anghernandez/angie-projects/pid-obstacle-avoidance-robot/media/modelo.jpg

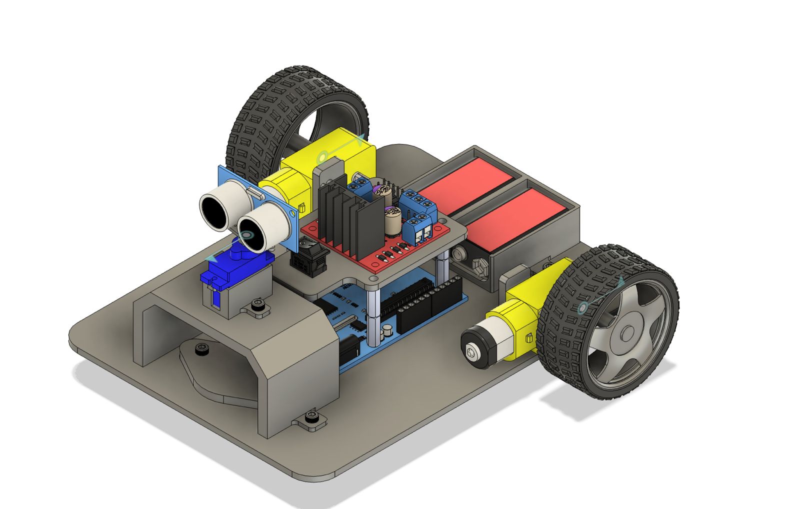
pid-obstacle-avoidance-robot/media/modelo.jpg
