anghernandez/angie-projects/pid-obstacle-avoidance-robot/media/carrito.JPG

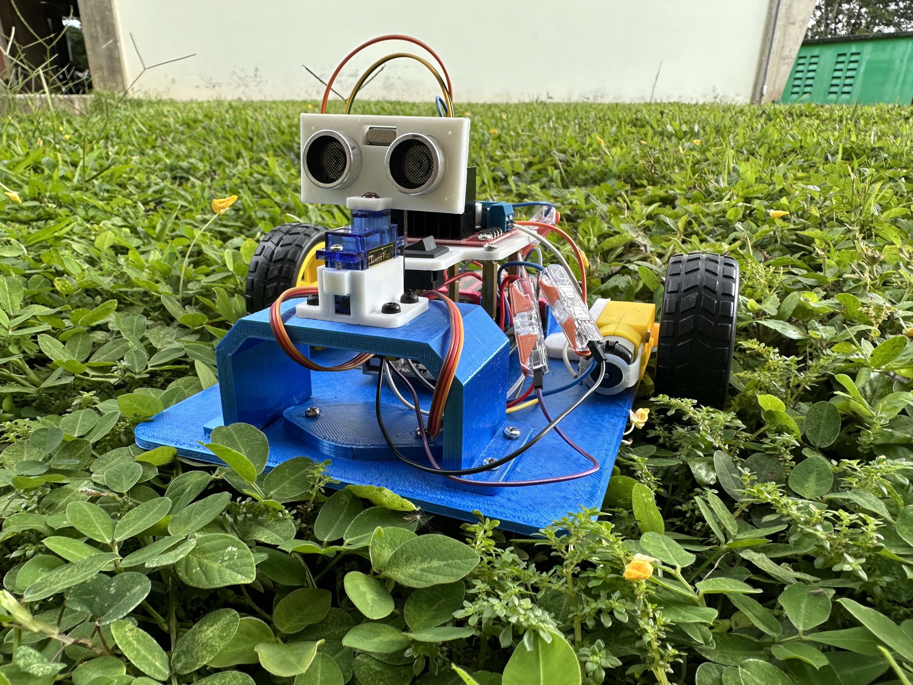
pid-obstacle-avoidance-robot/media/carrito.JPG
