anghernandez/angie-projects/pid-obstacle-avoidance-robot/docs/Proyecto Final.pdf

## Instituto Tecnológico de Costa Rica

## Escuela de Ingeniería Electrónica Laboratorio de Control Automático

# Carrito Evasor de Obstáculos

## Proyecto Fase 2

### Estudiantes:

### Nicole Corrales, Kimberley Morales, Angie Hernández

### Profesor: Pablo César Rodríguez Vargas

### Fecha: 20 de Noviembre 2025

## Contents

1 Introducción | 2
2 Proceso de Construcción | 3
3 Modelo Empírico de la Planta | 3
4 Diseño del Controlador | 6
5 Resultados | 7
6 Análisis de Resultados | 9
7 Conclusiones y Recomendaciones | 9
8 Bibliografía | 10
A Código Fuente | 11
B Planos de Construcción | 22

Abstract

En este proyecto se desarrolla una planta constituida por un carro móvil evasor de obstáculos, cuya dinámica se modela a partir de datos experimentales con el fin de diseñar un controlador adecuado, el sistema emplea un sensor ultrasónico para medir la distancia frente a los obstáculos, dos motores DC controlados mediante un driver L298N, una rueda loca frontal y un módulo Arduino como unidad de procesamiento. A partir del modelo empírico obtenido, se implementa un controlador PID orientado a mejorar la estabilidad y el comportamiento dinámico del vehículo ante variaciones en su entorno.
Los resultados experimentales demuestran que el controlador incrementa la estabilidad del sistema y permite un desplazamiento más preciso y seguro, manteniendo una distancia adecuada frente a obstáculos y mejorando la respuesta general del carro.

Palabras clave: control PID, modelo empírico, carro evasor de obstáculos, control automático, dinámica de sistemas.

## 1 Introducción

El proyecto desarrollado consiste en el diseño, modelado e implementación de un sistema de control aplicado a un carro móvil evasor de obstáculos, la motivación radica en llevar a la práctica los principios teóricos estudiados en el curso de Control Automático, aplicando metodologías reales de modelado, identificación, diseño de controladores y validación experimental. El trabajo permite integrar el análisis matemático con experimentación física, el uso de herramientas como MATLAB y la puesta en marcha de un sistema funcional construido desde cero.
La planta está conformada por un vehículo móvil de dos ruedas motrices y una rueda loca frontal, equipado con un sensor ultrasónico encargado de medir la distancia frontal df ante un obstáculo, el sistema utiliza un Arduino como unidad de procesamiento, un driver L298N para accionar los motores y una señal PWM compartida como variable manipulada. De esta forma, la velocidad lineal del carro depende directamente del valor de la señal de control aplicada, permitiendo influir sobre su capacidad de aproximarse o alejarse de objetos en su trayectoria.
Con base en los datos experimentales obtenidos, se construyó un modelo empírico que describe la relación dinámica entre la señal PWM aplicada a los motores (entrada u) y la distancia frontal medida (salida y = df ). Este modelo permitió diseñar un controlador PID orientado a regular la distancia del vehículo respecto a un obstáculo, manteniéndola en un valor deseado dref. El objetivo de control consiste en garantizar estabilidad, rechazo de perturbaciones y una respuesta suave ante variaciones inesperadas en el entorno. Este documento presenta el desarrollo completo del proyecto, desde la construcción física del prototipo hasta el diseño, simulación e implementación del controlador, mostrando el desempeño obtenido con y sin compensación.

## 2 Proceso de Construcción

El prototipo del carro evasor de obstáculos fue construido mediante un diseño modular fabricado completamente en impresión 3D, cada componente estructural se elaboró como una pieza independiente para facilitar el ensamblaje, mantenimiento y reemplazo, se desarrollaron módulos específicos para la base principal, soporte de baterías, soporte del driver L298N, plataforma frontal, bases de motor y la estructura destinada al sensor ultrasónico y al servomotor.
La locomoción del vehículo se realiza mediante dos motores DC laterales, cada uno fijado a una base impresa que permite una sujeción rígida y estable, en el extremo frontal se incorpora una rueda loca montada dentro de una cavidad diseñada para garantizar un movimiento suave y evitar atascos al cambiar de dirección. La estructura general proporciona rigidez mecánica y distribuye el peso de forma uniforme sobre el chasis. Para la detección de obstáculos se empleó un sensor ultrasónico HC-SR04, montado en la parte frontal sobre una base elevada creada para asegurar que el sensor permanezca perpendicular a los objetos en su trayectoria. El soporte fue fijado mediante tornillería, logrando un alineamiento estable y evitando vibraciones, inicialmente, los motores fueron instalados en posición vertical, pero debido a problemas de fragilidad en la base impresa, se rediseñó la instalación para colocarlos en posición horizontal, mejorando así la resistencia mecánica del conjunto.
El sistema se alimenta mediante dos baterías recargables de 9 V conectadas en serie para incrementar el voltaje disponible, estas alimentan directamente el driver L298N, el cual distribuye energía tanto a los motores como al Arduino. No fue necesario el uso de una protoboard, ya que todas las conexiones funcionales se realizaron a través de los bornes del driver y los pines del microcontrolador, reduciendo el cableado y mejorando la estabilidad eléctrica.
Finalmente, se integró todo el sistema dentro del chasis 3D, asegurando accesibilidad al Arduino y al driver, espacio para las baterías y buena ventilación alrededor de los componentes.

## 3 Modelo Empírico de la Planta

Para obtener un modelo dinámico que describiera el comportamiento del carro móvil frente a variaciones de la señal de control, se realizaron tres experimentos utilizando diferentes niveles de PWM aplicados a los motores: 90, 110 y 130. En cada prueba, el vehículo se desplazó directamente hacia un obstáculo mientras se registraban simultáneamente la señal de entrada u(t) (PWM) y la distancia frontal df (t) medida mediante el sensor ultrasónico HC-SR04. Las señales se adquirieron con un tiempo de muestreo de Ts = 0.05 s.
Previo a cada experimento, se añadió un bloque de muestras en reposo para garantizar un inicio consistente y permitir que el algoritmo de identificación considerara correctamente el instante del escalón. Los datos fueron organizados en objetos iddata de

MATLAB para su posterior procesamiento.

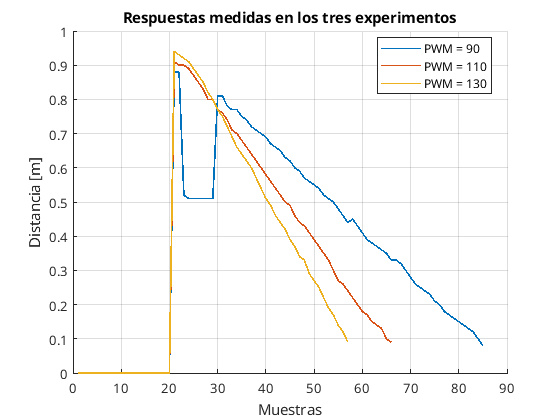
[picture p3: figure]

Figure 1: Respuestas medidas en los tres experimentos realizados con PWM = 90, 110 y 130.

La Fig. 1 muestra las respuestas medidas a los distintos niveles de PWM, se observa que valores mayores de PWM producen un acercamiento más rápido al obstáculo, lo cual confirma la naturaleza monótona del sistema dinámico.
Del conjunto de datos disponible, se seleccionó la medición asociada a PWM = 110 como referencia para la identificación del modelo, por presentar un comportamiento intermedio y menos afectado por saturación o ruido. A partir de estos datos se estimaron distintos modelos mediante el comando tfest, evaluando las siguientes estructuras:
- Modelo de un polo (primer orden)
- Modelo de dos polos
- Modelo de un polo con retardo puro

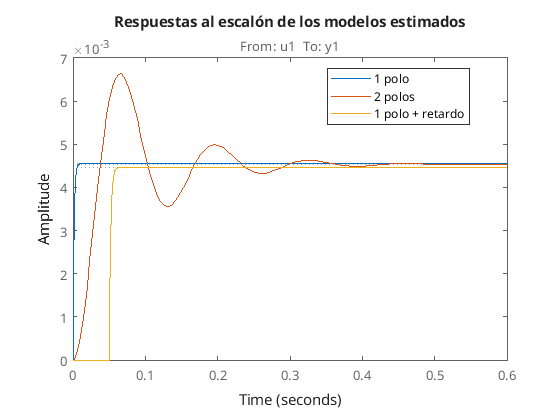
[picture p4: figure]

Figure 2: Comparación de la respuesta al escalón de los modelos estimados.

La Fig. 2 muestra la comparación entre los distintos modelos estimados. El modelo de dos polos presentó el mejor ajuste global, logrando reproducir con mayor fidelidad la curvatura inicial y el comportamiento transitorio observado en los datos experimentales. A diferencia del modelo de un polo, que resulta más simplificado, el modelo de dos polos captura mejor los efectos dinámicos adicionales presentes en la señal real, reduciendo el error entre el modelo y la medición.
El modelo seleccionado corresponde entonces a un sistema de dos polos, cuya estructura general es:
G(s) = | K (s + p1)(s + p2)
,

con los parámetros estimados mediante tfest:

- Ganancia: K ≈ 4.2 × 10⁻³
- Primer polo: p1 ≈ 20.8
- Segundo polo: p2 ≈ 1.64

Este modelo describe de mejor manera la dinámica del sistema, especialmente en el régimen transitorio, y constituye la base utilizada para el diseño del controlador PID implementado.
Finalmente, la respuesta al escalón en lazo cerrado con el controlador PID diseñado (ver Sección correspondiente) se muestra en la Fig. 3, la cual evidencia que el modelo identificado permite obtener una compensación estable y con buen desempeño dinámico.

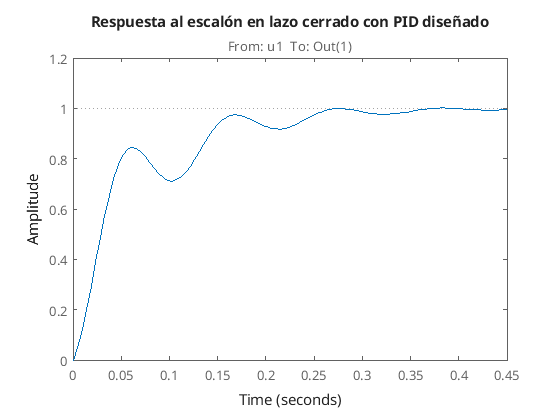
[picture p5: figure]

Figure 3: Respuesta al escalón en lazo cerrado utilizando el PID diseñado.

## 4 Diseño del Controlador

El diseño del controlador se realizó utilizando el modelo empírico identificado previamente para la planta, a partir de los datos experimentales, el sistema se aproximó mediante un modelo discreto de dos polos con tiempo de muestreo Ts = 0.05 s, el cual fue empleado dentro de MATLAB para el diseño y ajuste de un controlador PID orientado a regular la distancia frontal df a un valor de referencia dref.
El objetivo principal del controlador era reducir el error en estado estacionario y mejorar la estabilidad del acercamiento al obstáculo, evitando oscilaciones o convergencias bruscas. Para ello, se utilizó la herramienta pidtune de MATLAB, tomando como punto de partida el modelo discreto obtenido mediante tfest, con este procedimiento se generaron parámetros iniciales del PID, que posteriormente fueron ajustados manualmente para obtener una respuesta más suave y con menor tiempo de establecimiento. Dado que la implementación final debía ejecutarse en un microcontrolador Arduino, se adoptó una formulación de PID incremental, la cual es numéricamente robusta, reduce problemas de saturación integral y es menos sensible al ruido de medición. El controlador incremental se expresa como:

u(k) = u(k − 1) + A e(k) + B e(k − 1) + C e(k − 2),

donde e(k) = dref − df (k) es el error en el instante k, y los coeficientes incrementales se relacionan con los parámetros clásicos del PID mediante discretización.

Los valores finales utilizados en la implementación fueron:

Ainc = 66.805, | Binc = −13.432, | Cinc = 4.705.

Estos coeficientes provienen de escalar los valores obtenidos por MATLAB (222.6841, −44.7737, 15.6834) mediante un factor de 0.3, lo cual permitió adecuar las magnitudes de control a la dinámica real del carro y evitar saturación del actuador (PWM).

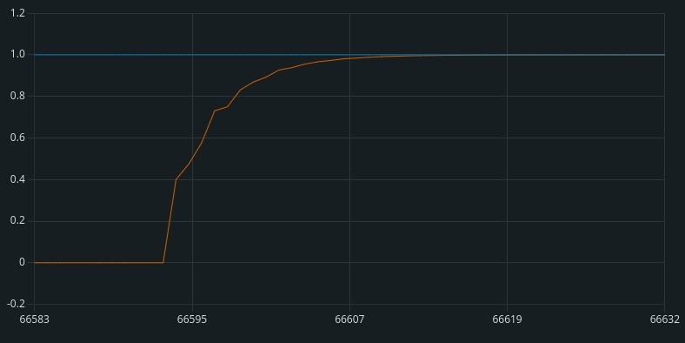
[picture p6: figure]

Figure 4: Respuesta al escalón obtenida en la simulación del PID implementado en Arduino.

La Fig. 4 muestra que el sistema converge suavemente hacia la referencia, sin sobrepaso significativo y con comportamiento estable, validando así el diseño del controlador.

## 5 Resultados

En esta sección se presentan los comportamientos experimentales del sistema sin control y con el controlador PID implementado, con el fin de comparar el desempeño dinámico en ambos casos.

### 5.1 Sistema sin compensación

Las pruebas sin controlador muestran que el vehículo no es capaz de mantener una distancia estable respecto al obstáculo. Al aplicar un PWM fijo, la distancia frontal disminuye de manera casi lineal, evidenciando que el sistema carece de mecanismos de regulación. Las respuestas de distancia para distintos niveles de PWM se muestran en la Fig. 5.

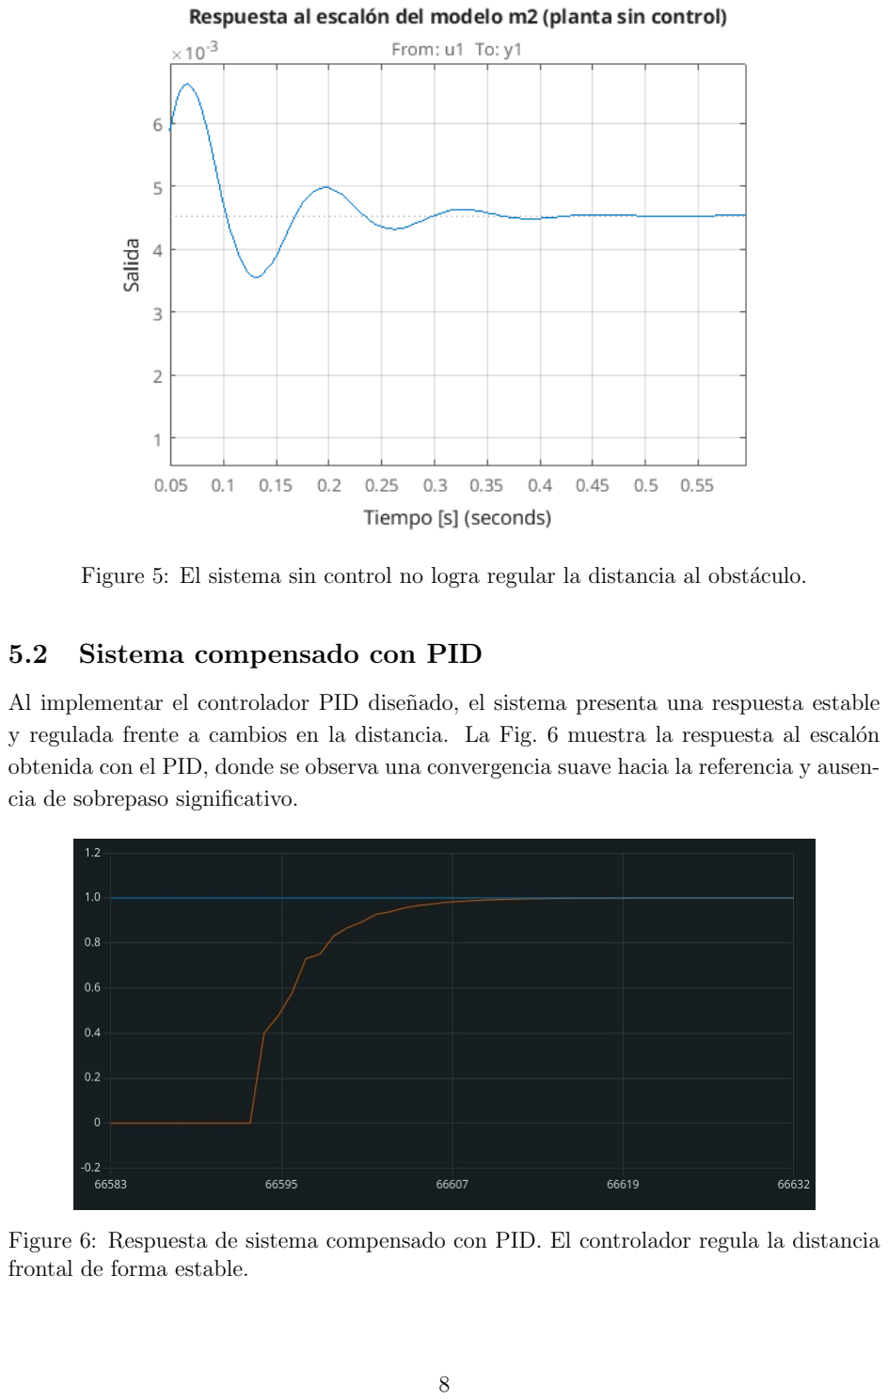
[picture p7: page 9]

Figure 5: El sistema sin control no logra regular la distancia al obstáculo.

### 5.2 Sistema compensado con PID

Al implementar el controlador PID diseñado, el sistema presenta una respuesta estable y regulada frente a cambios en la distancia. La Fig. 6 muestra la respuesta al escalón obtenida con el PID, donde se observa una convergencia suave hacia la referencia y ausencia de sobrepaso significativo.

Figure 6: Respuesta de sistema compensado con PID. El controlador regula la distancia frontal de forma estable.

## 6 Análisis de Resultados

Los resultados obtenidos evidencian que el controlador PID diseñado cumple de manera efectiva con los objetivos de regulación planteados para el sistema, en las pruebas sin control, el carro se aproxima al obstáculo de forma no regulada, mostrando un comportamiento dominado únicamente por la velocidad de los motores y sin capacidad de mantener una distancia estable. Este comportamiento confirma que la planta, por sí sola, no posee mecanismos de estabilización ni rechazo de perturbaciones.
Una vez implementado el controlador PID, la dinámica del sistema cambia de forma significativa, la respuesta al escalón en lazo cerrado muestra una convergencia suave hacia la referencia, sin sobrepasos relevantes y con un error en estado estacionario prácticamente nulo. El controlador compensa adecuadamente las variaciones en la distancia detectada, ajustando la señal PWM para mantener el valor deseado incluso ante perturbaciones. La comparación entre ambos escenarios demuestra que el PID logra transformar un sistema inherentemente no regulado en uno estable y capaz de mantener un comportamiento controlado. La dinámica obtenida en lazo cerrado es consistente con el modelo identificado, validando tanto el proceso de identificación como la metodología de diseño del controlador. Además, los resultados experimentales concuerdan con las simulaciones realizadas, lo cual confirma que los parámetros ajustados del PID son adecuados para la planta real.
En conjunto, los resultados permiten concluir que el control aplicado es preciso, robusto y cumple los objetivos propuestos en términos de regulación, estabilidad y rechazo de perturbaciones, garantizando un comportamiento seguro del carro durante el movimiento.

## 7 Conclusiones y Recomendaciones

### 7.1 Conclusiones

El proyecto cumplió de manera satisfactoria con los objetivos planteados, el modelo empírico obtenido fue adecuado para representar la dinámica principal del sistema y permitió diseñar un controlador PID funcional. Con el control implementado, el carro fue capaz de reaccionar correctamente ante un obstáculo y ajustar su distancia de manera rápida y estable, demostrando la efectividad del enfoque aplicado.
El trabajo permitió comprender de manera práctica el proceso completo de diseño de un sistema de control: desde la obtención de datos y modelado de la planta, hasta la implementación del PID en hardware real. Durante el desarrollo se identificó inicialmente una incompatibilidad entre el modelo empírico y el controlador diseñado, lo que llevó a un proceso de ajuste y validación que fortaleció la comprensión del comportamiento real de la planta y de los parámetros del PID.
El proyecto también permitió observar limitaciones prácticas del sistema, como la diferencia de respuesta entre los motores, que ocasionaba desviaciones laterales, este comportamiento mostró que, aunque el controlador regulaba la distancia frontal, el desempeño en trayectoria dependía de factores mecánicos adicionales no incluidos en el modelo.
En conjunto, el sistema logró un control estable, preciso y funcional, cumpliendo con los objetivos académicos y prácticos establecidos.

### 7.2 Recomendaciones

Para trabajos futuros, se recomienda explorar controladores más avanzados que permitan no solo regular la distancia frontal, sino también mejorar el seguimiento de trayectoria y compensar diferencias entre motores, entre las posibles mejoras se destacan:

- implementar controladores independientes por rueda, integrando control diferencial;
- añadir filtrado a la señal del sensor ultrasónico para reducir ruido y mejorar la

medición;

- incorporar sensores adicionales como encoders o unidades inerciales (IMU);
- utilizar motores con mayor precisión o realimentación interna;
- extender el control para permitir giros, evasión lateral y navegación autónoma.

Además, se sugiere continuar refinando el proceso de identificación de la planta, considerando modelos más completos o técnicas avanzadas de identificación no lineal.

## 8 Bibliografía

[1] C. Rincón, J. Martínez, y A. Rodríguez, “Diseño sistema PID para el control de distancia de un vehículo seguidor de objetos,” 19th LACCEI Multi-Conference, Buenos Aires, Argentina, 2021. :contentReference[oaicite:0]index=0
[2] J. I. Collazo, E. Gorrostieta, J. Pedraza, U. Villaseñor, R. Romero, y
M. González, “Modelación de un robot móvil de dos ruedas con tracción diferencial,” 8º Congreso Nacional de Mecatrónica, Veracruz, México, 2009. :contentRefer-

ence[oaicite:1]index=1

[3] ElecFreaks, “HC-SR04 Ultrasonic Sensor Datasheet,” 2013. [En línea]. Disponible en: https://cdn.sparkfun.com/datasheets/Sensors/Proximity/HCSR04.pdf
[4] STMicroelectronics, “L298N Dual H-Bridge Motor Driver Datasheet,” 2010. [En línea]. Disponible en: https://www.st.com/resource/en/datasheet/l298.pdf
[5] Arduino Documentation, “PWM — Pulse Width Modulation,” 2024. [En línea]. Disponible en: https://docs.arduino.cc/learn/microcontrollers/

analog-output (https://docs.arduino.cc/learn/microcontrollers/analog-output)

[6] MathWorks, “System Identification Toolbox Documentation,” 2024. [En línea]. Disponible en: https://www.mathworks.com/help/ident
[7] MathWorks, “PID Tuning and Control Design,” 2024. [En línea]. Disponible en: https://www.mathworks.com/help/control/ref/pidtuner-app.html
[8] K. Ogata, Ingeniería de Control Moderna, 5ta ed., Pearson, 2010.

## A Código Fuente

Listing 1: Control PID para la planta

1
2 | # include < NewPing .h >
3 | # include < Servo .h >

4
5 Servo servoSensor ;

6
7 | # define TRIG_PIN A3
8 | # define ECHO_PIN A2
9 | # define MAX_DISTANCE 200
10 | NewPing sonar ( TRIG_PIN , ECHO_PIN , MAX_DISTANCE ) ;

11
12 | const int ENA = 5;
13 | const int IN1 = 10;
14 | const int IN2 = 8;
15 | const int ENB = 6;
16 | const int IN3 = 11;
17 | const int IN4 = 7;

18
19 | const double Ts = 0.05;
20 | unsigned long t0 ;

21
22 double ref = 0.30;

23
24 | const double Ainc = 0.25 * 222.6841;
25 | const double Binc = 0.25 * -44.7737;
26 | const double Cinc = 0.25 * 15.6834;

27
28 | double ek | = 0.0;
29 | double ekm1 = 0.0;
30 | double ekm2 = 0.0;
31 | double uk | = 0.0;
32 | double ukm1 = 0.0;

33
34 | double d_ema = 0.0;
35 | const double EMA_ALPHA = 0.2;

36
37 const double CTRL_GAIN = 13.0;

38 | const int | PWM_MAX | = 220;
39 | const int | PWM_MIN | = 70;

40
41 const double REF_BAND = 0.02;

42
43 const double D_EMERGENCY = 0.15;

44
45 bool INVERT_DIR = true ;

46
47 | const int OFFSET_RIGHT_FWD = 21;
48 | const int OFFSET_RIGHT_REV = 20;

49
50 | const int SERVO_CENTER = 90;
51 | const int SERVO_LEFT1 | = 120;
52 | const int SERVO_LEFT2 | = 140;
53 | const int SERVO_RIGHT1 = 60;
54 | const int SERVO_RIGHT2 = 40;

55
56 | const int TURN_PWM | = 130;
57 | const int TURN_STEPS | = 12;

58
59 | enum Mode { MODE_FOLLOW , MODE_AVOID_TURN };
60 | Mode mode = MODE_FOLLOW ;
61 | int | turnDir | = 0;
62 | int | turnSteps = 0;

63
64 | static inline float median3 ( float a , float b , float c ) {
65 | if ( a > b ) { float t = a ; a = b ; b = t ; }
66 | if ( b > c ) { float t = b ; b = c ; c = t ; }
67 | if ( a > b ) { float t = a ; a = b ; b = t ; }
68 | return b ;
69 | }

70
71 | double readDistanceM () {
72 | unsigned int c1 = sonar . ping_cm () ; if (! c1 ) c1 = MAX_DISTANCE ;
73 | unsigned int c2 = sonar . ping_cm () ; if (! c2 ) c2 = MAX_DISTANCE ;
74 | unsigned int c3 = sonar . ping_cm () ; if (! c3 ) c3 = MAX_DISTANCE ;
75 | float cm = median3 ( c1 , c2 , c3 ) ;
76 | return cm / 100.0;
77 | }

78
79 | double meanDistanceAtAngle (int angleDeg , int nSamples = 3) {
80 | servoSensor . write ( angleDeg ) ;
81 | delay (150) ;
82 | double sum = 0.0;
83 | for ( int i = 0; i < nSamples ; i ++) {
84 | double d = readDistanceM () ;
85 | if ( d > 2.0) d = 2.0;
86 | sum += d ;
87 | delay (40) ;
88 | }

89 | return sum / ( double ) nSamples ;
90 | }

91
92 | double scanSideMean (int side ) {
93 | double m1 , m2 ;
94 | if ( side < 0) {
95 | m1 = meanDistanceAtAngle ( SERVO_LEFT1 ) ;
96 | m2 = meanDistanceAtAngle ( SERVO_LEFT2 ) ;
97 | } else {
98 | m1 = meanDistanceAtAngle ( SERVO_RIGHT1 ) ;
99 | m2 = meanDistanceAtAngle ( SERVO_RIGHT2 ) ;
100 | }
101 | return 0.5 * ( m1 + m2 ) ;
102 | }

103
104 | void driveSignedPWM (int uSigned ) {
105 | int s = ( uSigned >= 0) ? +1 : -1;
106 | if ( INVERT_DIR ) s = -s ;

107
108 | int base = abs ( uSigned ) ;
109 | if ( base > PWM_MAX ) base = PWM_MAX ;

110
111 | int valLeft | = base ;
112 | int valRight = base ;

113
114 | if ( s > 0) {
115 | valRight -= OFFSET_RIGHT_FWD ;
116 | if ( valRight < 0) valRight = 0;
117 | } else {
118 | valRight -= OFFSET_RIGHT_REV ;
119 | if ( valRight < 0) valRight = 0;
120 | }

121
122 | digitalWrite ( IN1 , ( s > 0) ? HIGH : LOW ) ;
123 | digitalWrite ( IN2 , ( s > 0) ? LOW | : HIGH ) ;
124 | digitalWrite ( IN3 , ( s > 0) ? HIGH : LOW ) ;
125 | digitalWrite ( IN4 , ( s > 0) ? LOW | : HIGH ) ;

126
127 | analogWrite ( ENA , valLeft ) ;
128 | analogWrite ( ENB , valRight ) ;
129 | }

130
131 | void driveTurnInPlace (int dir , int pwm ) {
132 | if ( pwm > PWM_MAX ) pwm = PWM_MAX ;
133 | if ( pwm < PWM_MIN ) pwm = PWM_MIN ;

134
135 | if ( dir > 0) {
136 | digitalWrite ( IN1 , HIGH ) ; digitalWrite ( IN2 , LOW ) ;
137 | digitalWrite ( IN3 , LOW ) ; | digitalWrite ( IN4 , HIGH ) ;
138 | } else {
139 | digitalWrite ( IN1 , LOW ) ; | digitalWrite ( IN2 , HIGH ) ;

140 | digitalWrite ( IN3 , HIGH ) ; digitalWrite ( IN4 , LOW ) ;
141 | }

142
143 | analogWrite ( ENA , pwm ) ;
144 | analogWrite ( ENB , pwm ) ;
145 | }

146
147 | void resetPID () {
148 | uk | = 0.0;
149 | ukm1 = 0.0;
150 | ekm1 = 0.0;
151 | ekm2 = 0.0;
152 | }

153
154 | void startAvoidance () {
155 | driveSignedPWM (0) ;
156 | resetPID () ;

157
158 | double dLeftMean | = scanSideMean ( -1) ;
159 | double dRightMean = scanSideMean (+1) ;

160
161 | servoSensor . write ( SERVO_CENTER ) ;
162 | delay (150) ;

163
164 | if ( dLeftMean > dRightMean ) turnDir = -1;
165 | else | turnDir = +1;

166
167 | turnSteps = TURN_STEPS ;
168 | mode = MODE_AVOID_TURN ;

169
170 | t0 = millis () ;
171 | }

172
173 | void setup () {
174 | Serial . begin (115200) ;

175
176 | servoSensor . attach (9) ;
177 | servoSensor . write ( SERVO_CENTER ) ;
178 | delay (200) ;

179
180 | pinMode ( ENA , OUTPUT ) ; pinMode ( ENB , OUTPUT ) ;
181 | pinMode ( IN1 , OUTPUT ) ; pinMode ( IN2 , OUTPUT ) ;
182 | pinMode ( IN3 , OUTPUT ) ; pinMode ( IN4 , OUTPUT ) ;

183
184 | digitalWrite ( IN1 , LOW ) ; | digitalWrite ( IN2 , LOW ) ;
185 | digitalWrite ( IN3 , LOW ) ; | digitalWrite ( IN4 , LOW ) ;

186
187 | d_ema = readDistanceM () ;
188 | t0 = millis () ;
189 | }

190

191 | void loop () {
192 | if ( millis () - t0 < ( unsigned long ) ( Ts * 1000.0) ) return ;
193 | t0 += ( unsigned long ) ( Ts * 1000.0) ;

194
195 | double dist = readDistanceM () ;
196 | if ( dist > 2.0) dist = 2.0;

197
198 d_ema = (1.0 - EMA_ALPHA ) * d_ema + EMA_ALPHA * dist ;

199
200 | if ( mode == MODE_FOLLOW ) {
201 | ek = ref - d_ema ;

202
203 | if ( d_ema < D_EMERGENCY ) {
204 | startAvoidance () ;
205 | Serial . print ( ref , 3) ;
206 | Serial . print (" ") ;
207 | Serial . println ( d_ema , 3) ;
208 | return ;
209 | }

210
211 | if ( fabs ( ek ) <= REF_BAND ) {
212 | startAvoidance () ;
213 | Serial . print ( ref , 3) ;
214 | Serial . print (" ") ;
215 | Serial . println ( d_ema , 3) ;
216 | return ;
217 | }

218
219 | uk = ukm1 + Ainc * ek + Binc * ekm1 + Cinc * ekm2 ;

220
221 | if ( uk > | 10.0) uk = | 10.0;
222 | if ( uk < -10.0) uk = -10.0;

223
224 | double uAbs = fabs ( uk ) * CTRL_GAIN ;
225 | int pwm = ( int ) uAbs ;
226 | if ( pwm > PWM_MAX ) pwm = PWM_MAX ;
227 | if ( pwm < PWM_MIN ) pwm = PWM_MIN ;

228
229 | int sign = ( uk >= 0.0) ? +1 : -1;
230 | int uSigned = sign * pwm ;

231
232 | driveSignedPWM ( uSigned ) ;

233
234 | ekm2 = ekm1 ;
235 | ekm1 = ek ;
236 | ukm1 = uk ;

237
238 | Serial . print ( ref , 3) ;
239 | Serial . print (" ") ;
240 | Serial . println ( d_ema , 3) ;
241 | }

242 | else if ( mode == MODE_AVOID_TURN ) {
243 | if ( turnSteps > 0) {
244 | driveTurnInPlace ( turnDir , TURN_PWM ) ;
245 | turnSteps - -;
246 | } else {
247 | driveSignedPWM (0) ;
248 | resetPID () ;
249 | mode = MODE_FOLLOW ;
250 | servoSensor . write ( SERVO_CENTER ) ;
251 | delay (100) ;
252 | }

253
254 | Serial . print ( ref , 3) ;
255 | Serial . print (" ") ;
256 | Serial . println ( d_ema , 3) ;
257 | }
258 | }

Listing 2: Control en modo evasor de obstáculos mediante PID incremental

1 | # include < NewPing .h >
2 | # include < Servo .h >

3
4 | // ----------------------------
5 | // C o n f i g u r a c i n de hardware
6 | // ----------------------------
7 | Servo servoSensor ;

8
9 | # define TRIG_PIN | A3
10 | # define ECHO_PIN | A2
11 | # define MAX_DISTANCE 200

12
13 NewPing sonar ( TRIG_PIN , ECHO_PIN , MAX_DISTANCE ) ;

14
15 | const int ENA = 5;
16 | const int IN1 = 10;
17 | const int IN2 = 8;
18 | const int ENB = 6;
19 | const int IN3 = 11;
20 | const int IN4 = 7;

21
22 | // ----------------------------
23 | // P a r m e t r o s de control
24 | // ----------------------------
25 | const double Ts = 0.05; | // P e r o d o de muestreo [s]
26 | unsigned long t0 ;

27
28 | double ref = 0.30; | // Referencia de distancia [m]

29
30 | // Coeficientes PID incremental ( discretizado )
31 | const double Ainc = 0.25 * 222.6841;

32 | const double Binc = 0.25 * -44.7737;
33 | const double Cinc = 0.25 * 15.6834;

34
35 | double ek | = 0.0;
36 | double ekm1 = 0.0;
37 | double ekm2 = 0.0;
38 | double uk | = 0.0;
39 | double ukm1 = 0.0;

40
41 | // Filtro EMA para la m e d i c i n de distancia
42 | double d_ema = 0.0;
43 | const double EMA_ALPHA = 0.2;

44
45 | // Ganancias y l m i t e s del actuador
46 | const double CTRL_GAIN = 13.0;
47 | const int | PWM_MAX | = 220;
48 | const int | PWM_MIN | = 70;

49
50 | // Banda muerta alrededor de la referencia
51 | const double REF_BAND = 0.02;

52
53 | // Distancia de emergencia para e v a s i n
54 | const double D_EMERGENCY = 0.15;

55
56 | // Ajustes direccionales
57 | bool INVERT_DIR = true ;

58
59 | const int OFFSET_RIGHT_FWD = 21;
60 | const int OFFSET_RIGHT_REV = 20;

61
62 | // | ngulos | del servo
63 | const int SERVO_CENTER = 90;
64 | const int SERVO_LEFT1 | = 120;
65 | const int SERVO_LEFT2 | = 140;
66 | const int SERVO_RIGHT1 = 60;
67 | const int SERVO_RIGHT2 = 40;

68
69 | // P a r m e t r o s de giro evasivo
70 | const int TURN_PWM | = 130;
71 | const int TURN_STEPS = 12;

72
73 | // ----------------------------
74 | // Modos de o p e r a c i n
75 | // ----------------------------
76 | enum Mode { MODE_FOLLOW , MODE_AVOID_TURN };
77 | Mode mode = MODE_FOLLOW ;

78
79 | int turnDir | = 0;
80 | int turnSteps = 0;

81
82 // ----------------------------

83 | // Utilitarios
84 | // ----------------------------
85 | static inline float median3 ( float a , float b , float c ) {
86 | if ( a > b ) { float t = a ; a = b ; b = t ; }
87 | if ( b > c ) { float t = b ; b = c ; c = t ; }
88 | if ( a > b ) { float t = a ; a = b ; b = t ; }
89 | return b ;
90 | }

91
92 | double readDistanceM () {
93 | unsigned int c1 = sonar . ping_cm () ; if (! c1 ) c1 = MAX_DISTANCE ;
94 | unsigned int c2 = sonar . ping_cm () ; if (! c2 ) c2 = MAX_DISTANCE ;
95 | unsigned int c3 = sonar . ping_cm () ; if (! c3 ) c3 = MAX_DISTANCE ;

96
97 | float cm = median3 ( c1 , c2 , c3 ) ;
98 | return cm / 100.0; | // Pasar a metros
99 | }

100
101 | double meanDistanceAtAngle (int angleDeg , int nSamples = 3) {
102 | servoSensor . write ( angleDeg ) ;
103 | delay (150) ;

104
105 | double sum = 0.0;
106 | for ( int i = 0; i < nSamples ; i ++) {
107 | double d = readDistanceM () ;
108 | if ( d > 2.0) d = 2.0; | // Limitar a 2 m
109 | sum += d ;
110 | delay (40) ;
111 | }
112 | return sum / ( double ) nSamples ;
113 | }

114
115 | double scanSideMean (int side ) {
116 | double m1 , m2 ;
117 | if ( side < 0) {
118 | m1 = meanDistanceAtAngle ( SERVO_LEFT1 ) ;
119 | m2 = meanDistanceAtAngle ( SERVO_LEFT2 ) ;
120 | } else {
121 | m1 = meanDistanceAtAngle ( SERVO_RIGHT1 ) ;
122 | m2 = meanDistanceAtAngle ( SERVO_RIGHT2 ) ;
123 | }
124 | return 0.5 * ( m1 + m2 ) ;
125 | }

126
127 | // ----------------------------
128 | // A c t u a c i n sobre motores
129 | // ----------------------------
130 | void driveSignedPWM (int uSigned ) {
131 | int s = ( uSigned >= 0) ? +1 : -1;
132 | if ( INVERT_DIR ) s = -s ;

133

134 | int base = abs ( uSigned ) ;
135 | if ( base > PWM_MAX ) base = PWM_MAX ;

136
137 | int valLeft | = base ;
138 | int valRight = base ;

139
140 | if ( s > 0) {
141 | valRight -= OFFSET_RIGHT_FWD ;
142 | if ( valRight < 0) valRight = 0;
143 | } else {
144 | valRight -= OFFSET_RIGHT_REV ;
145 | if ( valRight < 0) valRight = 0;
146 | }

147
148 | digitalWrite ( IN1 , ( s > 0) ? HIGH : LOW ) ;
149 | digitalWrite ( IN2 , ( s > 0) ? LOW | : HIGH ) ;
150 | digitalWrite ( IN3 , ( s > 0) ? HIGH : LOW ) ;
151 | digitalWrite ( IN4 , ( s > 0) ? LOW | : HIGH ) ;

152
153 | analogWrite ( ENA , valLeft ) ;
154 | analogWrite ( ENB , valRight ) ;
155 | }

156
157 | void driveTurnInPlace (int dir , int pwm ) {
158 | if ( pwm > PWM_MAX ) pwm = PWM_MAX ;
159 | if ( pwm < PWM_MIN ) pwm = PWM_MIN ;

160
161 | if ( dir > 0) {
162 | digitalWrite ( IN1 , HIGH ) ; digitalWrite ( IN2 , LOW ) ;
163 | digitalWrite ( IN3 , LOW ) ; | digitalWrite ( IN4 , HIGH ) ;
164 | } else {
165 | digitalWrite ( IN1 , LOW ) ; | digitalWrite ( IN2 , HIGH ) ;
166 | digitalWrite ( IN3 , HIGH ) ; digitalWrite ( IN4 , LOW ) ;
167 | }

168
169 | analogWrite ( ENA , pwm ) ;
170 | analogWrite ( ENB , pwm ) ;
171 | }

172
173 | // ----------------------------
174 | // G e s t i n del PID
175 | // ----------------------------
176 | void resetPID () {
177 | uk | = 0.0;
178 | ukm1 = 0.0;
179 | ekm1 = 0.0;
180 | ekm2 = 0.0;
181 | }

182
183 | // ----------------------------
184 | // L g i c a de e v a s i n

185 | // ----------------------------
186 | void startAvoidance () {
187 | driveSignedPWM (0) ;
188 | resetPID () ;

189
190 | double dLeftMean | = scanSideMean ( -1) ;
191 | double dRightMean = scanSideMean (+1) ;

192
193 | servoSensor . write ( SERVO_CENTER ) ;
194 | delay (150) ;

195
196 | if ( dLeftMean > dRightMean ) turnDir = -1;
197 | else | turnDir = +1;

198
199 | turnSteps = TURN_STEPS ;
200 | mode | = MODE_AVOID_TURN ;

201
202 | t0 = millis () ;
203 | }

204
205 | // ----------------------------
206 | // Setup y bucle principal
207 | // ----------------------------
208 | void setup () {
209 | Serial . begin (115200) ;

210
211 | servoSensor . attach (9) ;
212 | servoSensor . write ( SERVO_CENTER ) ;
213 | delay (200) ;

214
215 | pinMode ( ENA , OUTPUT ) ; pinMode ( ENB , OUTPUT ) ;
216 | pinMode ( IN1 , OUTPUT ) ; pinMode ( IN2 , OUTPUT ) ;
217 | pinMode ( IN3 , OUTPUT ) ; pinMode ( IN4 , OUTPUT ) ;

218
219 | digitalWrite ( IN1 , LOW ) ; | digitalWrite ( IN2 , LOW ) ;
220 | digitalWrite ( IN3 , LOW ) ; | digitalWrite ( IN4 , LOW ) ;

221
222 | d_ema = readDistanceM () ;
223 | t0 | = millis () ;
224 | }

225
226 | void loop () {
227 | if ( millis () - t0 < ( unsigned long ) ( Ts * 1000.0) ) return ;
228 | t0 += ( unsigned long ) ( Ts * 1000.0) ;

229
230 | double dist = readDistanceM () ;
231 | if ( dist > 2.0) dist = 2.0;

232
233 | // Filtro EMA
234 | d_ema = (1.0 - EMA_ALPHA ) * d_ema + EMA_ALPHA * dist ;

235

236 | if ( mode == MODE_FOLLOW ) {
237 | ek = ref - d_ema ;

238
239 | // Condiciones para iniciar e v a s i n
240 | if ( d_ema < D_EMERGENCY ) {
241 | startAvoidance () ;
242 | Serial . print ( ref , 3) ;
243 | Serial . print (" ") ;
244 | Serial . println ( d_ema , 3) ;
245 | return ;
246 | }

247
248 | if ( fabs ( ek ) <= REF_BAND ) {
249 | startAvoidance () ;
250 | Serial . print ( ref , 3) ;
251 | Serial . print (" ") ;
252 | Serial . println ( d_ema , 3) ;
253 | return ;
254 | }

255
256 | // PID incremental
257 | uk = ukm1 + Ainc * ek + Binc * ekm1 + Cinc * ekm2 ;

258
259 | if ( uk > | 10.0) uk = | 10.0;
260 | if ( uk < -10.0) uk = -10.0;

261
262 | double uAbs = fabs ( uk ) * CTRL_GAIN ;
263 | int pwm = ( int ) uAbs ;
264 | if ( pwm > PWM_MAX ) pwm = PWM_MAX ;
265 | if ( pwm < PWM_MIN ) pwm = PWM_MIN ;

266
267 | int sign | = ( uk >= 0.0) ? +1 : -1;
268 | int uSigned = sign * pwm ;

269
270 | driveSignedPWM ( uSigned ) ;

271
272 | ekm2 = ekm1 ;
273 | ekm1 = ek ;
274 | ukm1 = uk ;

275
276 | Serial . print ( ref , 3) ;
277 | Serial . print (" ") ;
278 | Serial . println ( d_ema , 3) ;
279 | }
280 | else if ( mode == MODE_AVOID_TURN ) {
281 | if ( turnSteps > 0) {
282 | driveTurnInPlace ( turnDir , TURN_PWM ) ;
283 | turnSteps - -;
284 | } else {
285 | driveSignedPWM (0) ;
286 | resetPID () ;

287 | mode = MODE_FOLLOW ;
288 | servoSensor . write ( SERVO_CENTER ) ;
289 | delay (100) ;
290 | }

291
292 | Serial . print ( ref , 3) ;
293 | Serial . print (" ") ;
294 | Serial . println ( d_ema , 3) ;
295 | }
296 | }

## B Planos de Construcción

A continuación se presentan los planos de fabricación utilizados para la construcción del prototipo del carro evasor de obstáculos, cada plano fue modelado en CAD e impreso en 3D para conformar la estructura completa del robot.

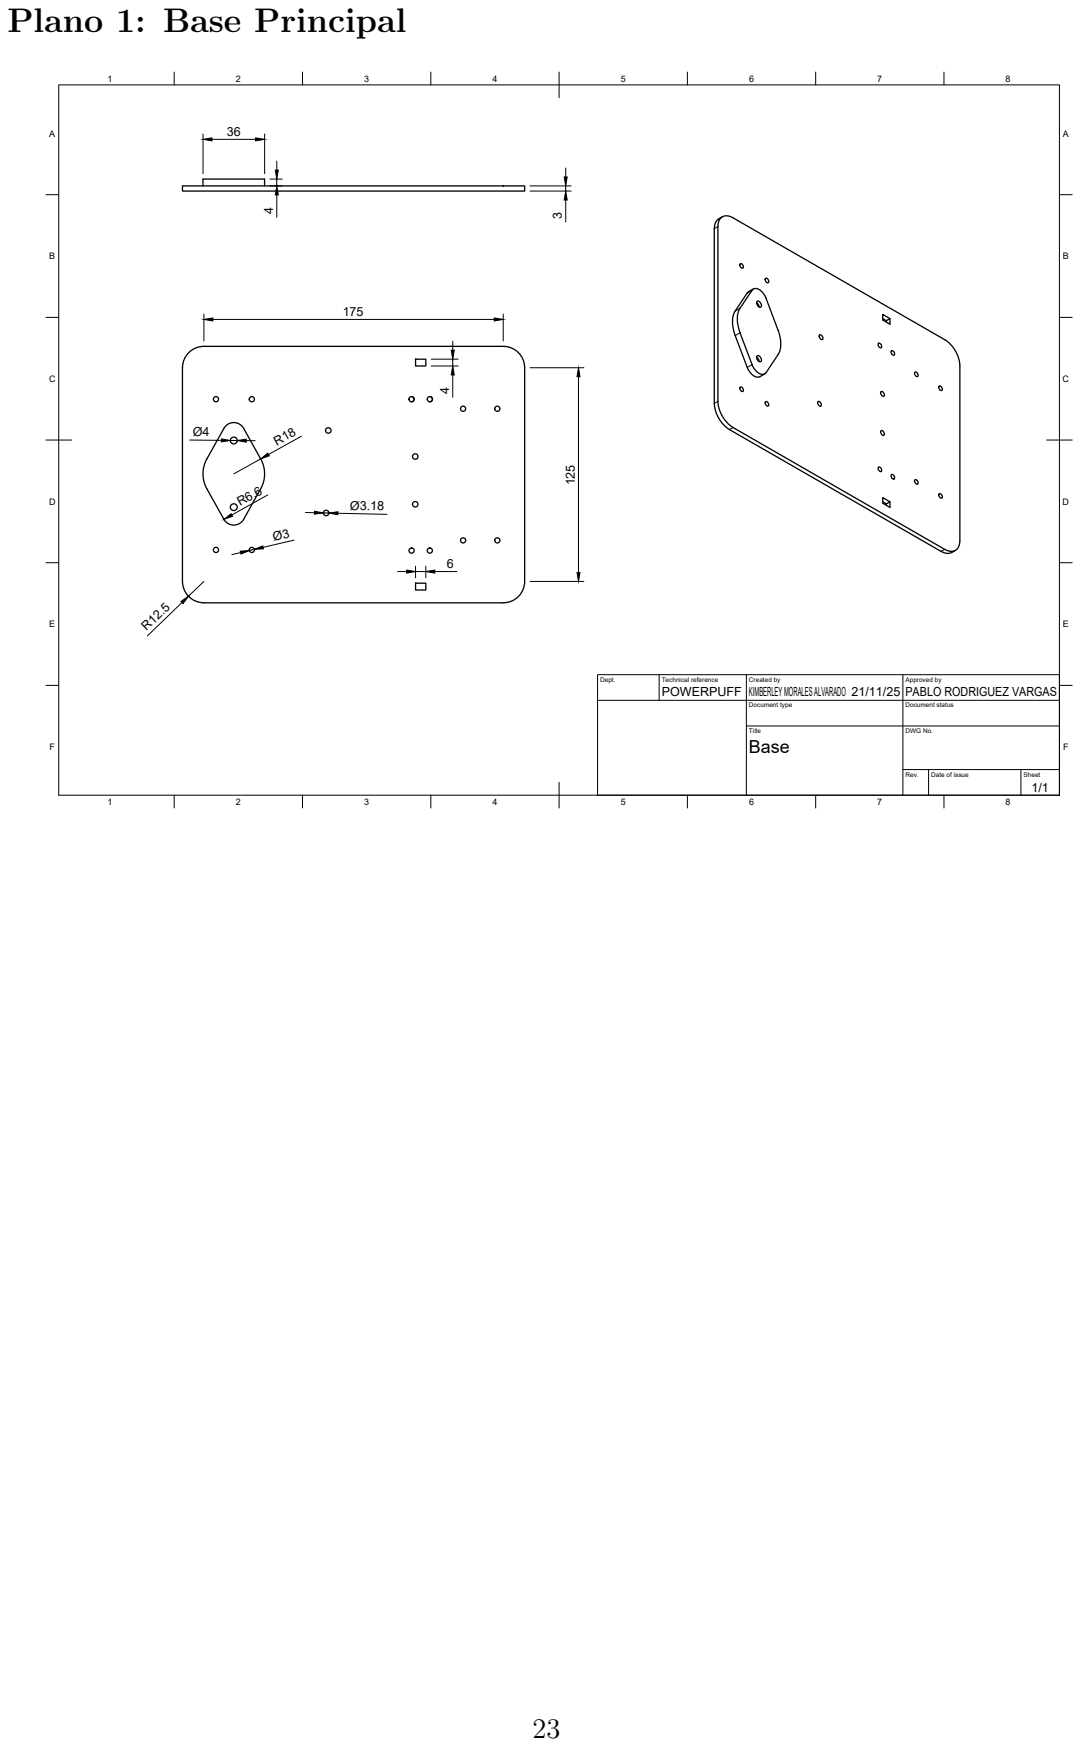
[picture p8: page 24]
Dept.; Technical reference; Created by; Approved by; Document type; Document status; Title; DWG No.; Rev.; Date of issue; Sheet; Base; POWERPUFF; KIMBERLEY MORALES ALVARADO; PABLO RODRIGUEZ VARGAS

Plano 1: Base Principal

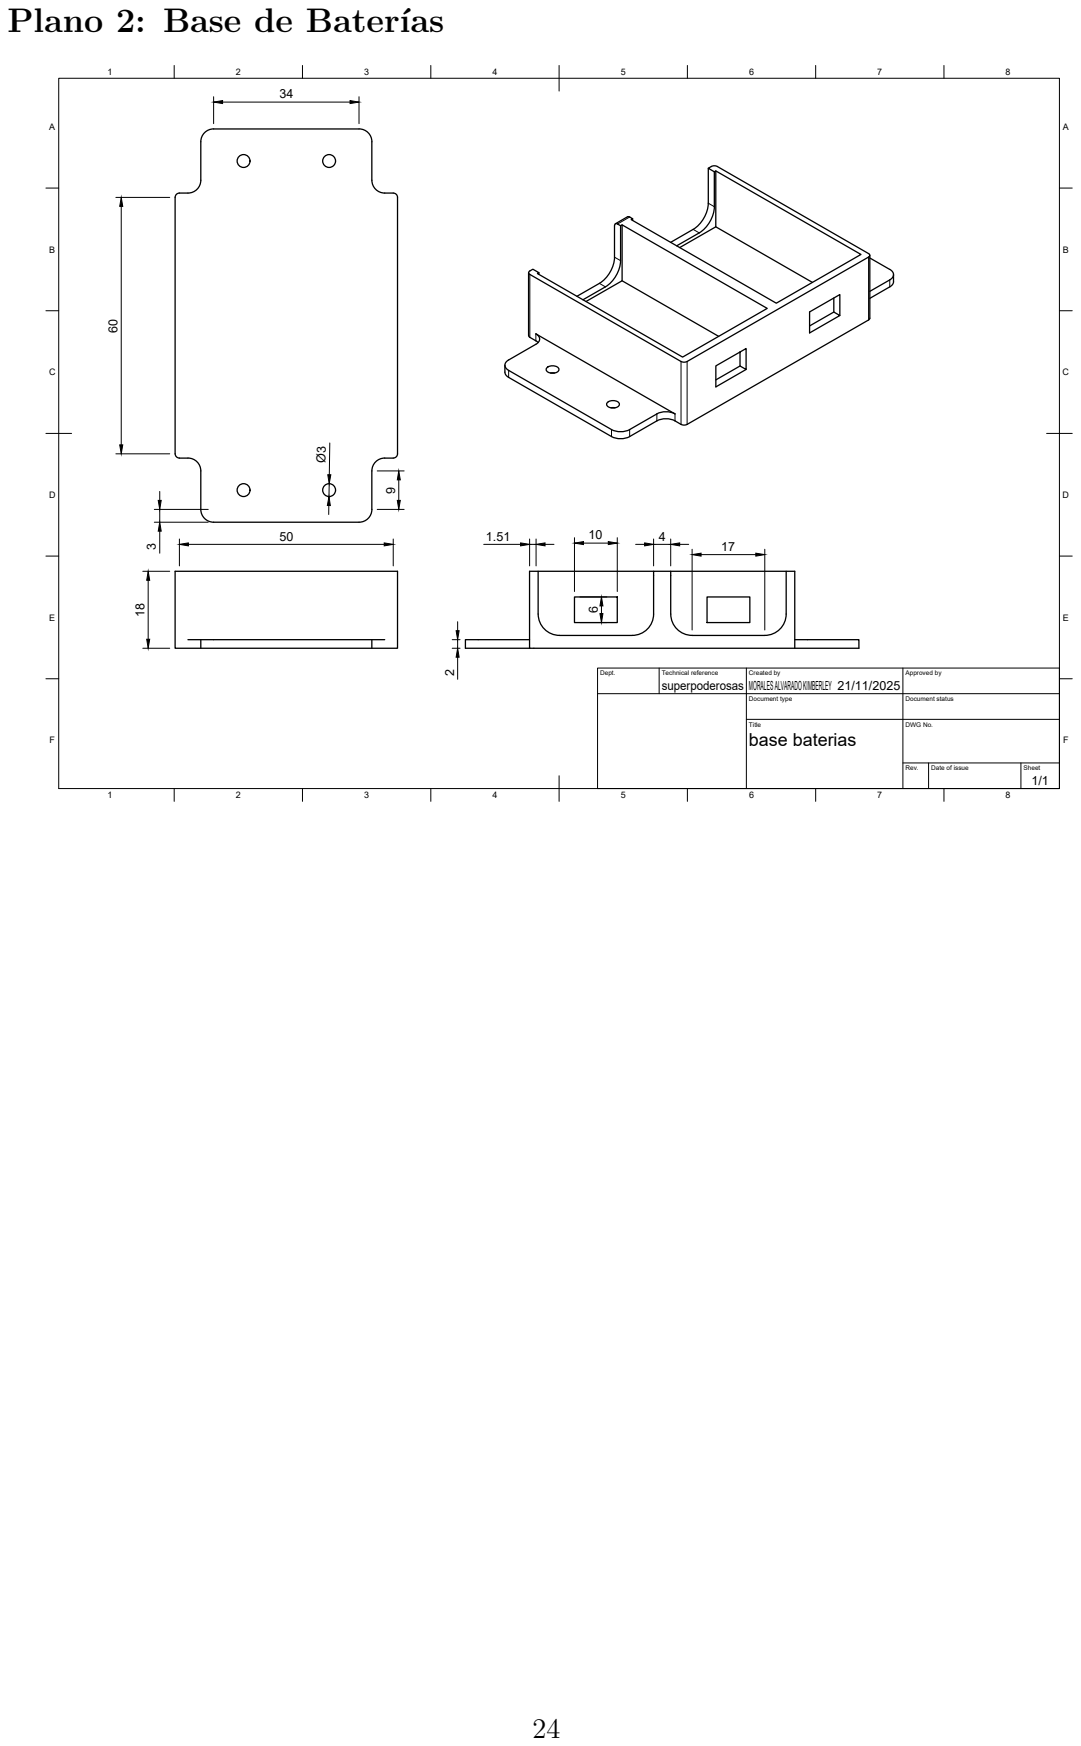
[picture p9: page 25]
Dept.; Technical reference; Created by; Approved by; Document type; Document status; Title; DWG No.; Rev.; Date of issue; Sheet; base baterias; superpoderosas; MORALES ALVARADO KIMBERLEY ⁶⁰

Plano 2: Base de Baterías

22.72 ²²

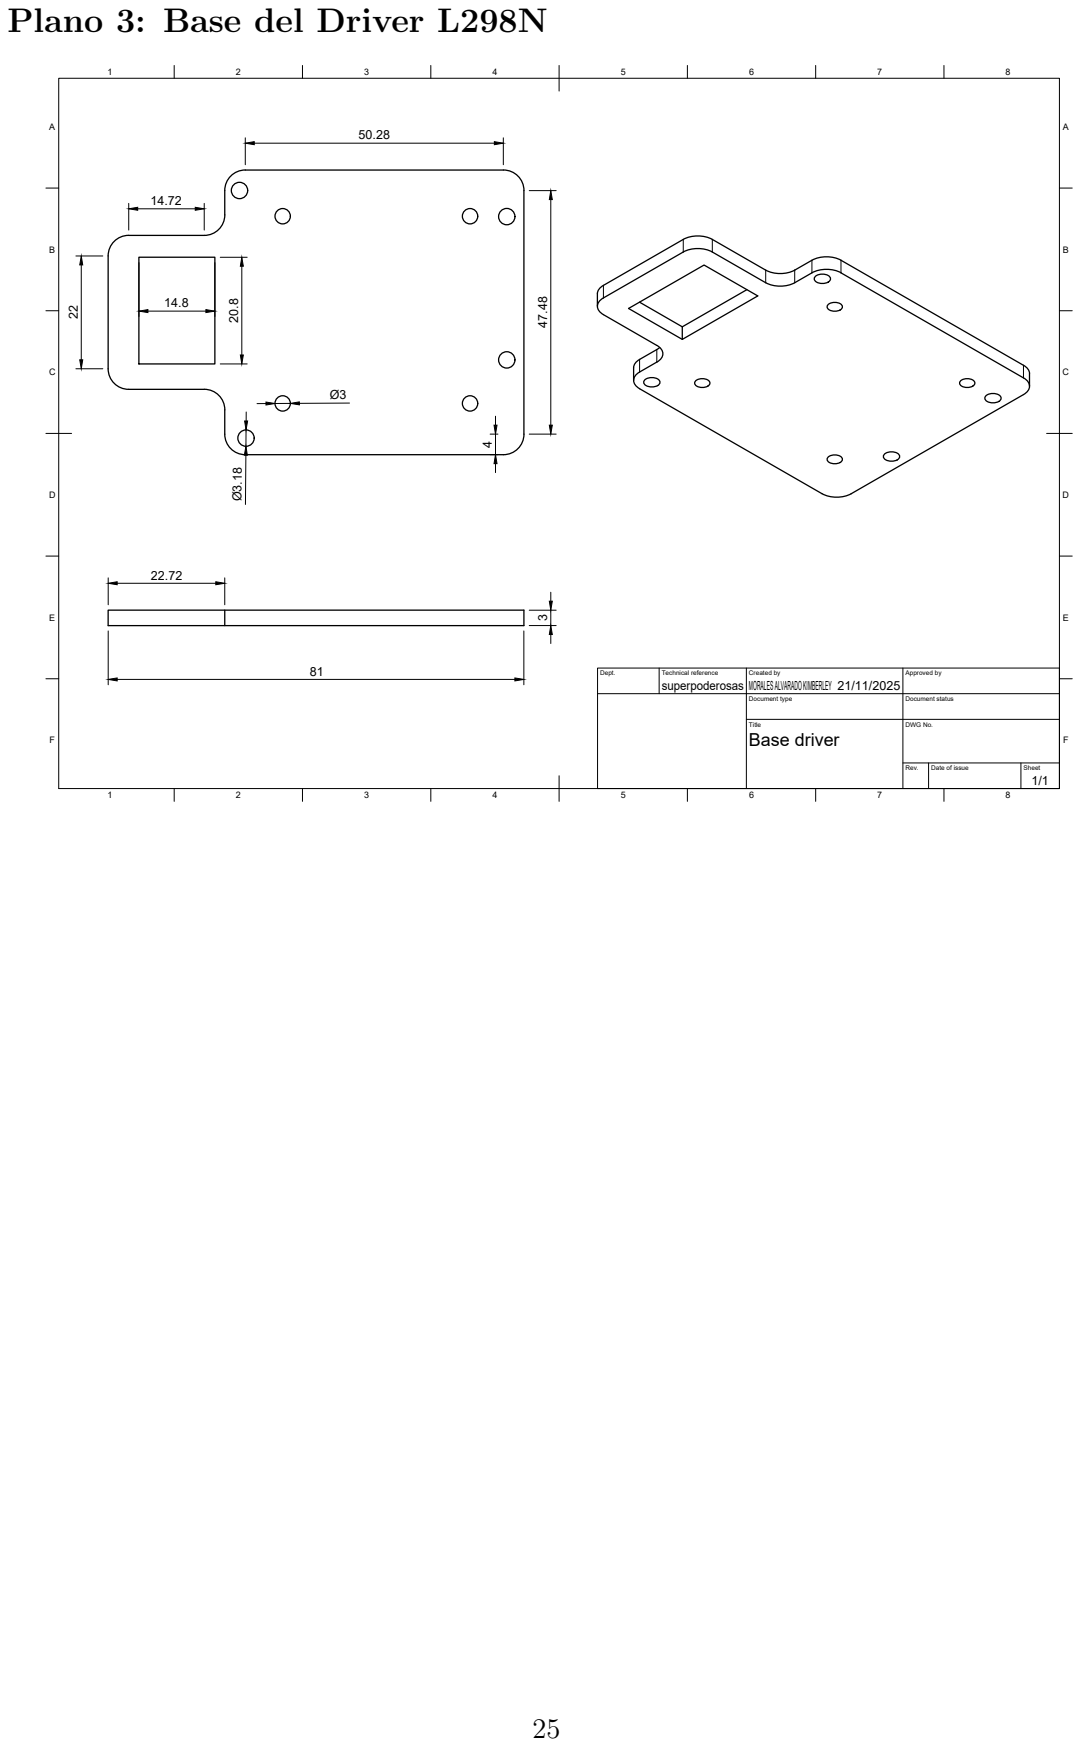
[picture p10: page 26]
Dept.; Technical reference; Created by; Approved by; Document type; Document status; Title; DWG No.; Rev.; Date of issue; Sheet; Base driver; superpoderosas; MORALES ALVARADO KIMBERLEY

Plano 3: Base del Driver L298N

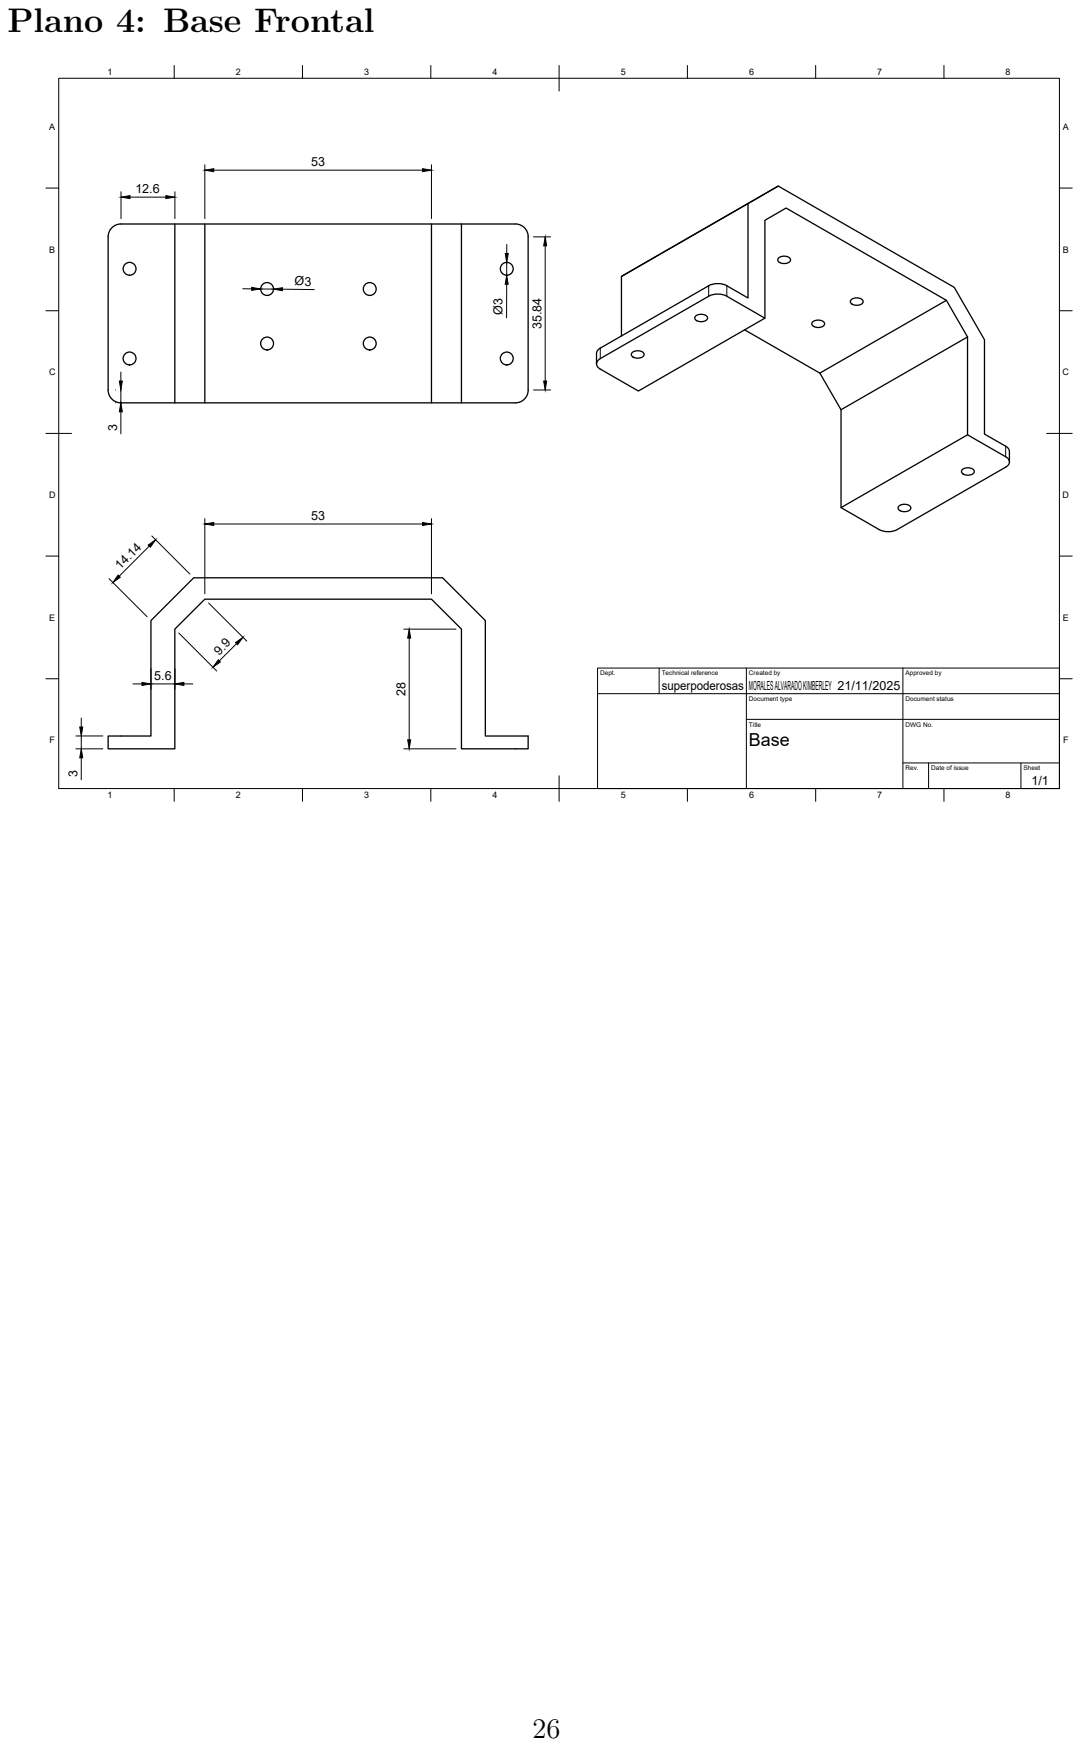
[picture p11: page 27]
Dept.; Technical reference; Created by; Approved by; Document type; Document status; Title; DWG No.; Rev.; Date of issue; Sheet; Base; superpoderosas; MORALES ALVARADO KIMBERLEY

Plano 4: Base Frontal

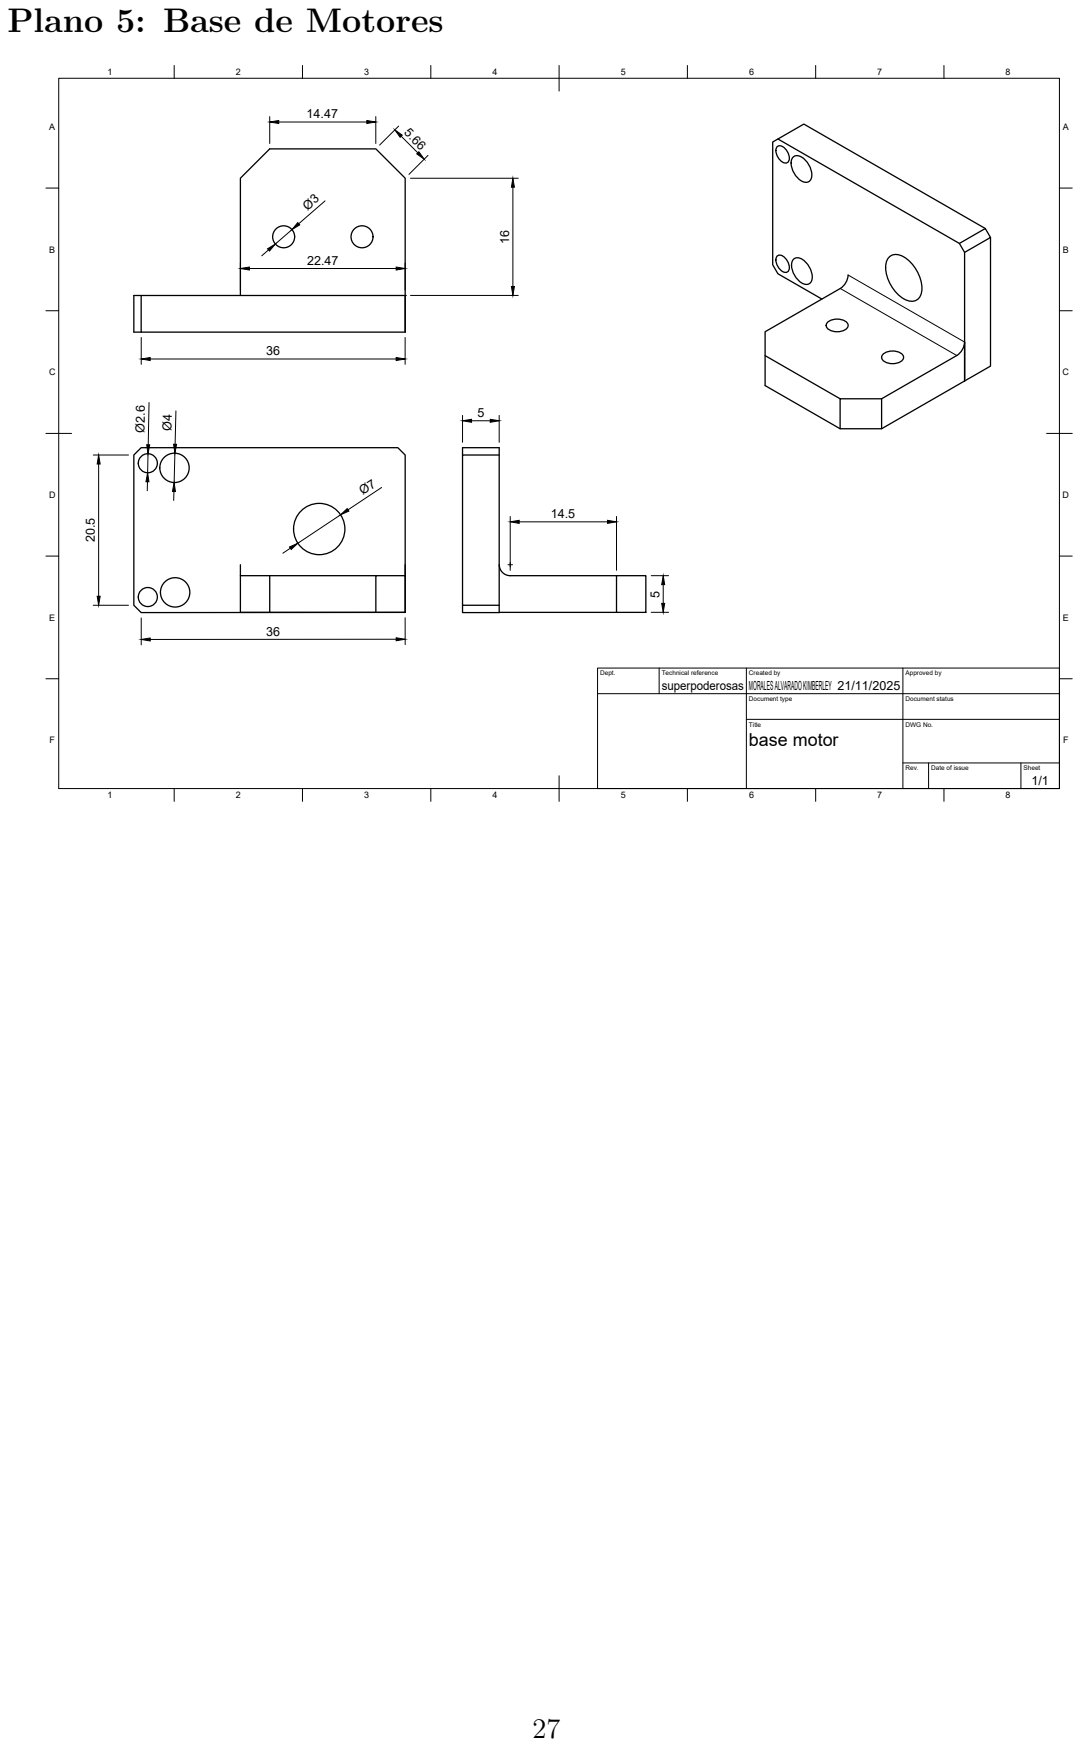
[picture p12: page 28]
Dept.; Technical reference; Created by; Approved by; Document type; Document status; Title; DWG No.; Rev.; Date of issue; Sheet; base motor; superpoderosas; MORALES ALVARADO KIMBERLEY

Plano 5: Base de Motores

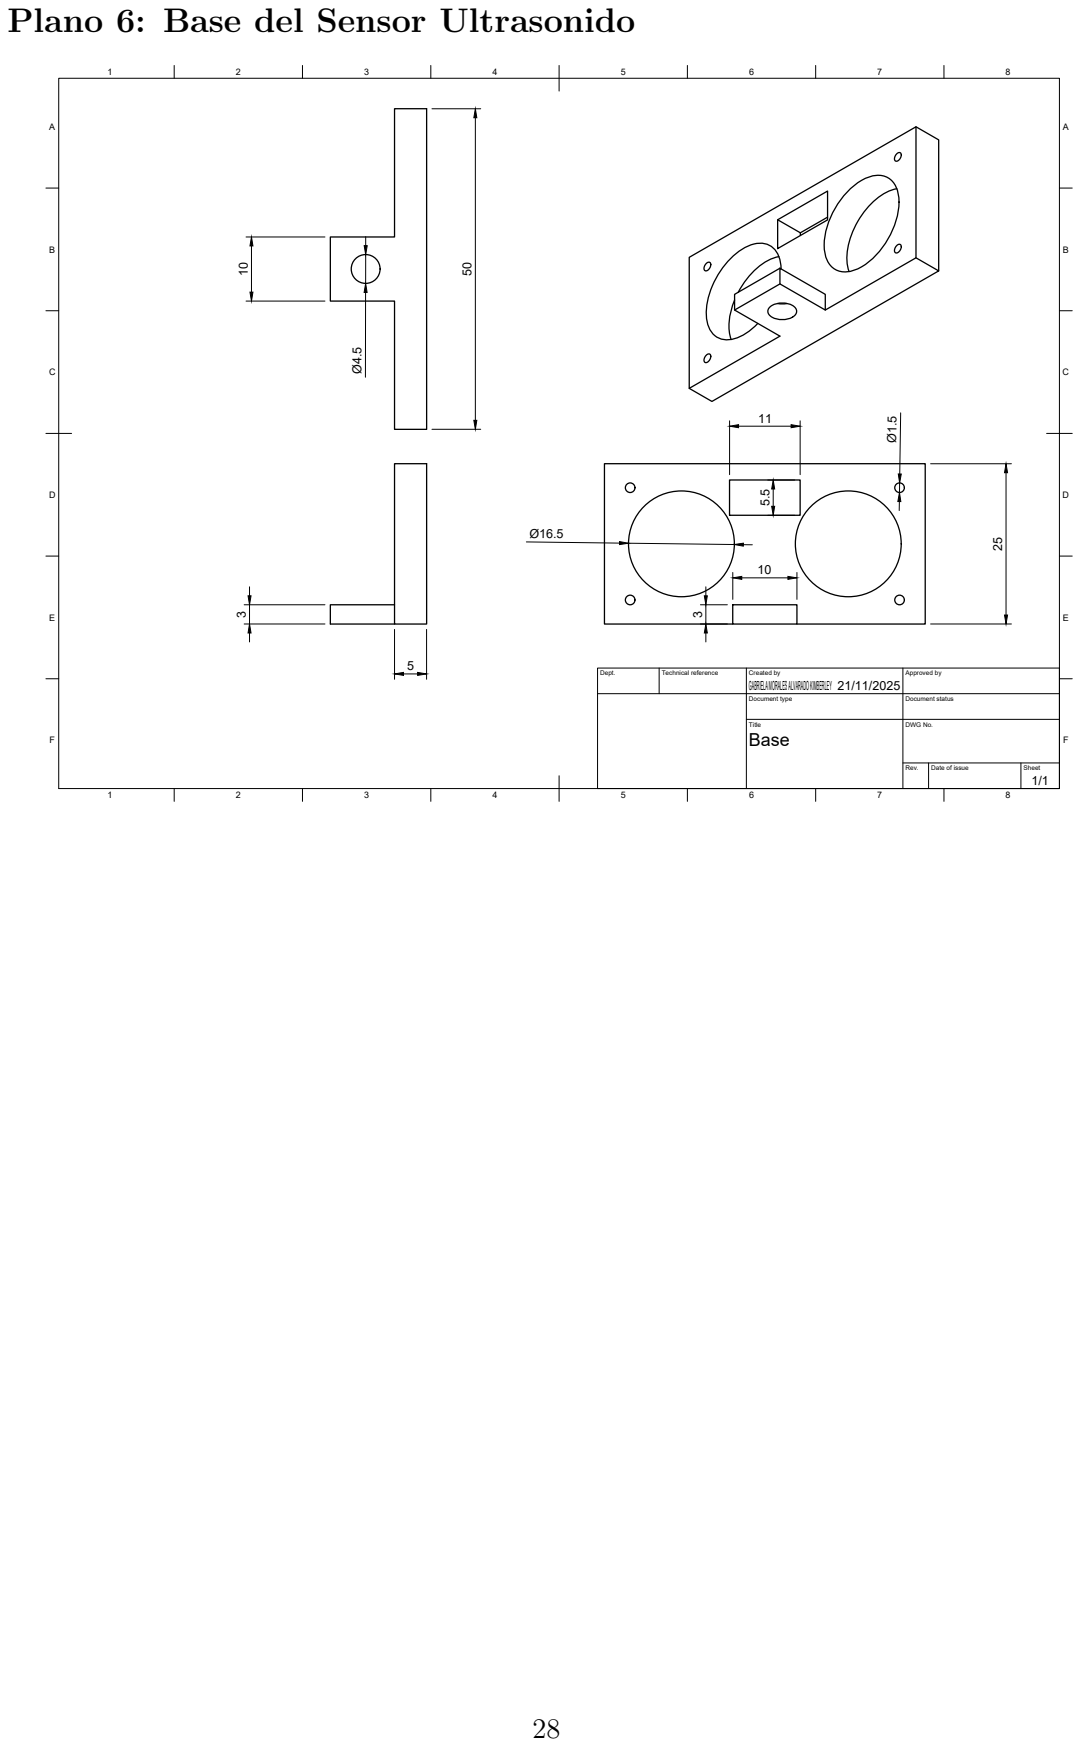
[picture p13: page 29]
Dept.; Technical reference; Created by; Approved by; Document type; Document status; Title; DWG No.; Rev.; Date of issue; Sheet; Base; GABRIELA MORALES ALVARADO KIMBERLEY ¹⁰

Plano 6: Base del Sensor Ultrasonido

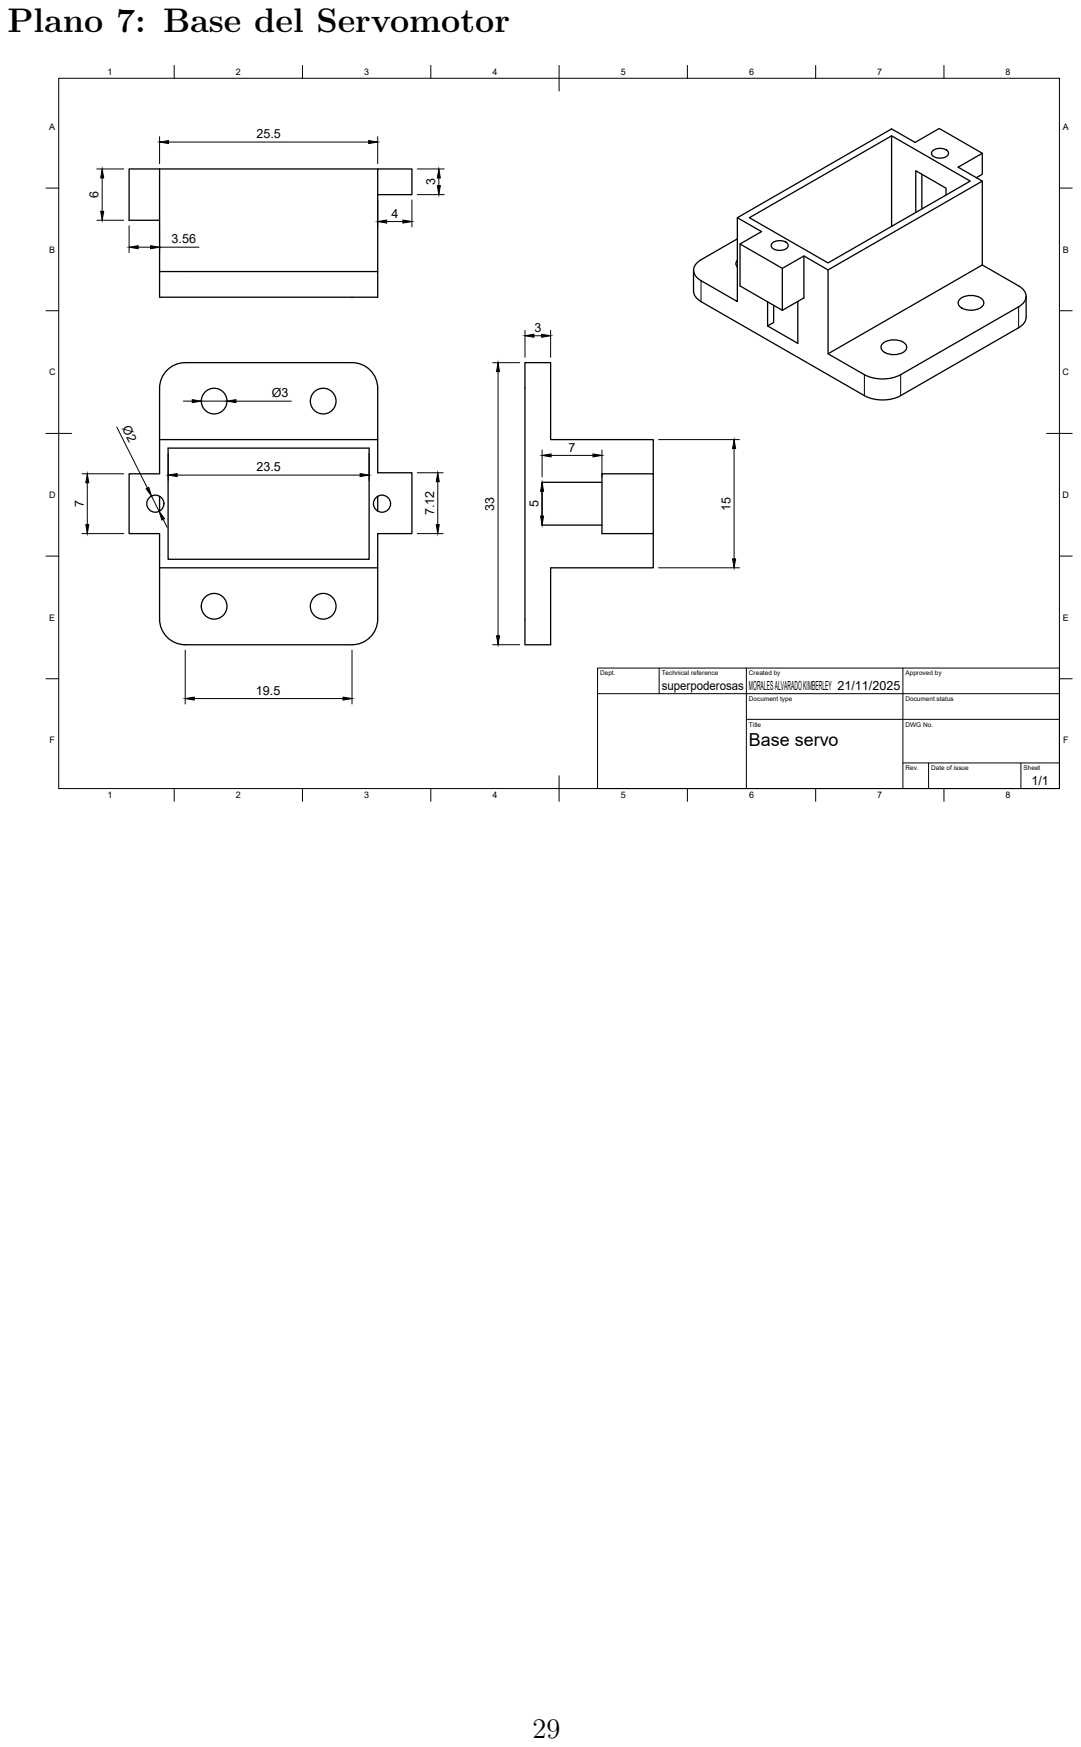
[picture p14: page 30]
Dept.; Technical reference; Created by; Approved by; Document type; Document status; Title; DWG No.; Rev.; Date of issue; Sheet; Base servo; superpoderosas; MORALES ALVARADO KIMBERLEY

Plano 7: Base del Servomotor

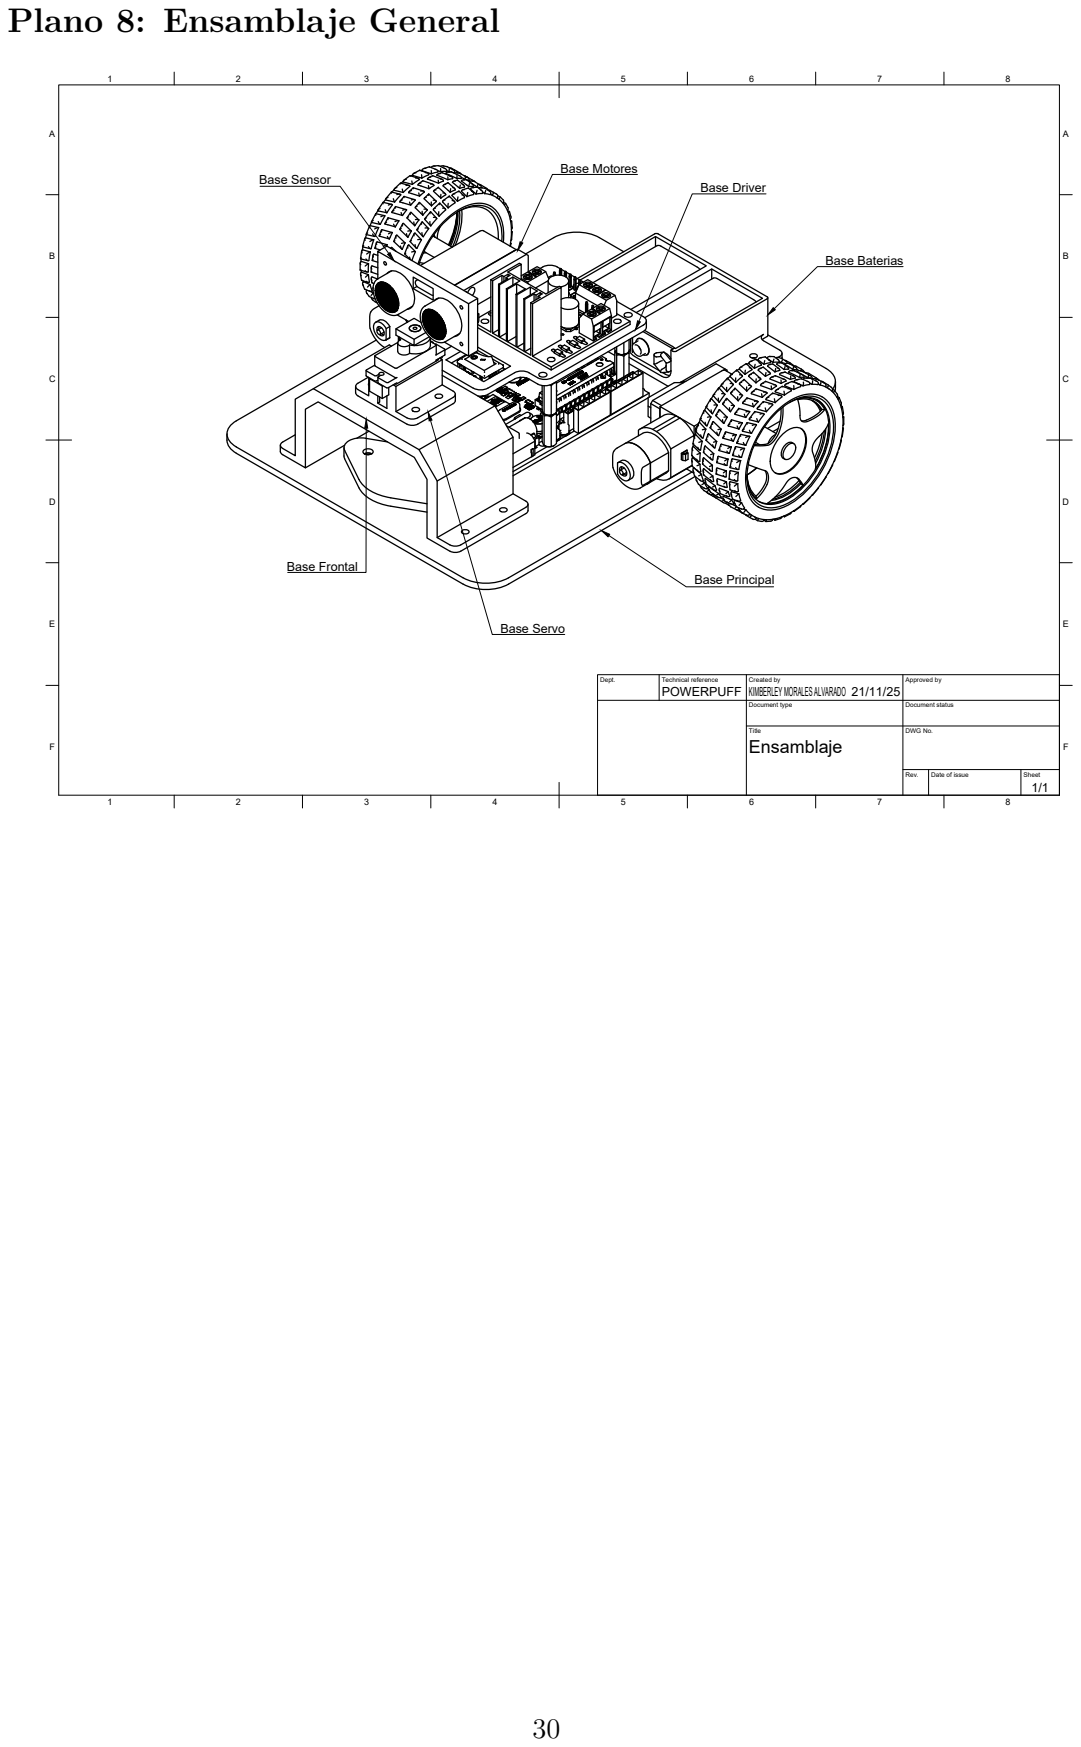
[picture p15: page 31]
Dept.; Technical reference; Created by; Approved by; Document type; Document status; Title; DWG No.; Rev.; Date of issue; Sheet; Ensamblaje; POWERPUFF; KIMBERLEY MORALES ALVARADO; Base Principal; Base Frontal; Base Motores; Base Baterias; Base Driver; Base Servo; Base Sensor

Plano 8: Ensamblaje General
