anghernandez/angie-projects/battle-city-c/GameOver.bmp

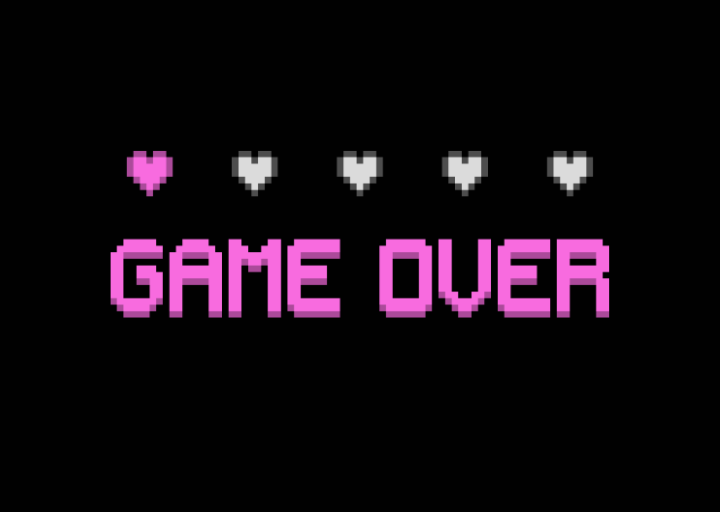
battle-city-c/GameOver.bmp
