anghernandez/angie-projects/battle-city-c/gameover.bmp

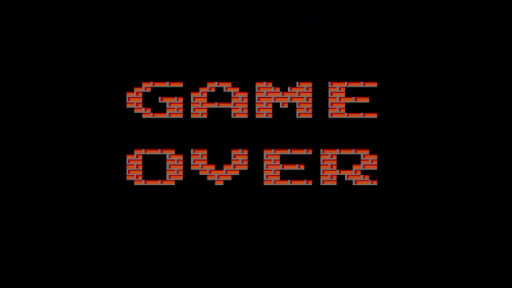
battle-city-c/gameover.bmp
