anghernandez/angie-projects/battle-city-c/Inicio.bmp

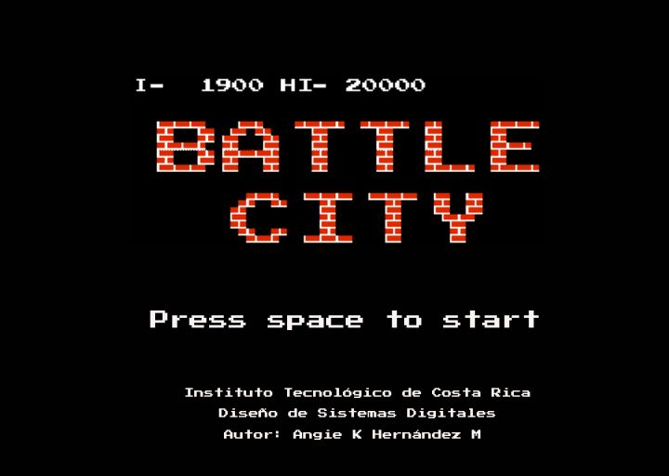
battle-city-c/Inicio.bmp
