anghernandez/angie-projects/battle-city-c/Tanques16.bmp

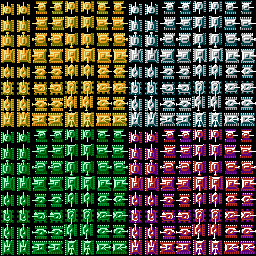
battle-city-c/Tanques16.bmp
