anghernandez/angie-projects/battle-city-c/win.bmp

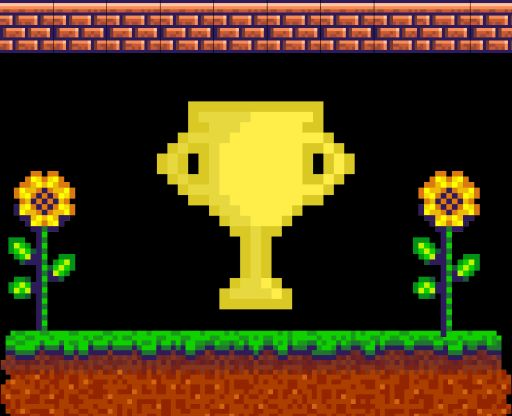
battle-city-c/win.bmp
