anghernandez/angie-projects/pid-obstacle-avoidance-robot/hardware/ARCHIVOS_CAD/Base_sensor.step

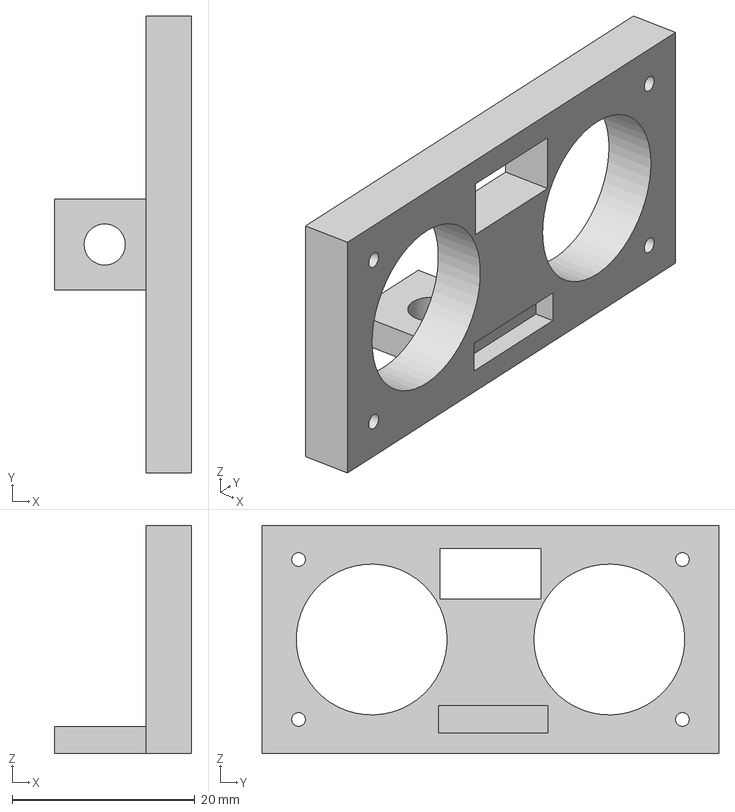
[picture p21: CAD file, 2026-04-10]
pid-obstacle-avoidance-robot/hardware/ARCHIVOS_CAD/Base_sensor.step
15.0 x 50.0 x 25.0 mm
