anghernandez/angie-projects/pid-obstacle-avoidance-robot/hardware/ARCHIVOS_CAD/Arco.step

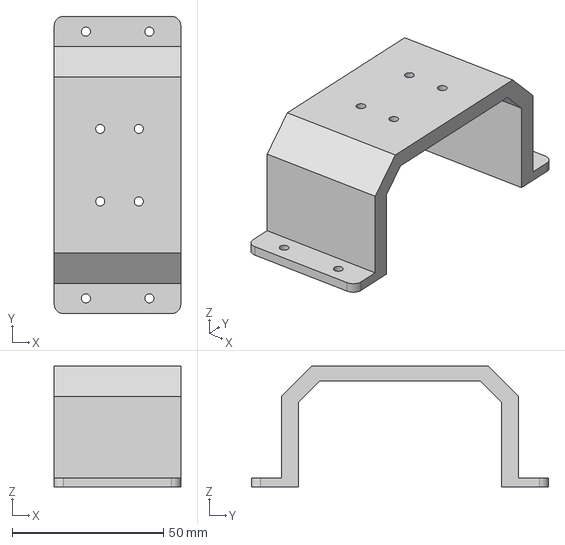
[picture p22: CAD file, 2026-04-10]
pid-obstacle-avoidance-robot/hardware/ARCHIVOS_CAD/Arco.step
41.8 x 98.2 x 40.0 mm
