anghernandez/angie-projects/pid-obstacle-avoidance-robot/hardware/ARCHIVOS_CAD/Base.step

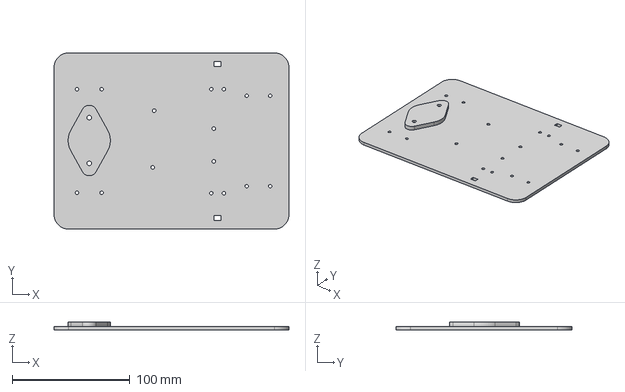
[picture p23: CAD file, 2026-04-10]
pid-obstacle-avoidance-robot/hardware/ARCHIVOS_CAD/Base.step
200.0 x 150.0 x 7.00 mm
