anghernandez/angie-projects/pid-obstacle-avoidance-robot/hardware/ARCHIVOS_CAD/Base_servo.step

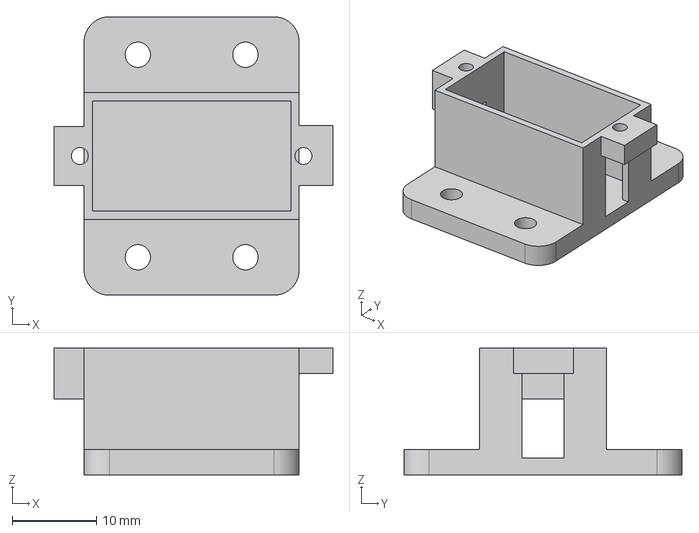
[picture p24: CAD file, 2026-04-10]
pid-obstacle-avoidance-robot/hardware/ARCHIVOS_CAD/Base_servo.step
33.1 x 33.0 x 15.0 mm
