anghernandez/angie-projects/pid-obstacle-avoidance-robot/hardware/ARCHIVOS_CAD/Base_bateria.step

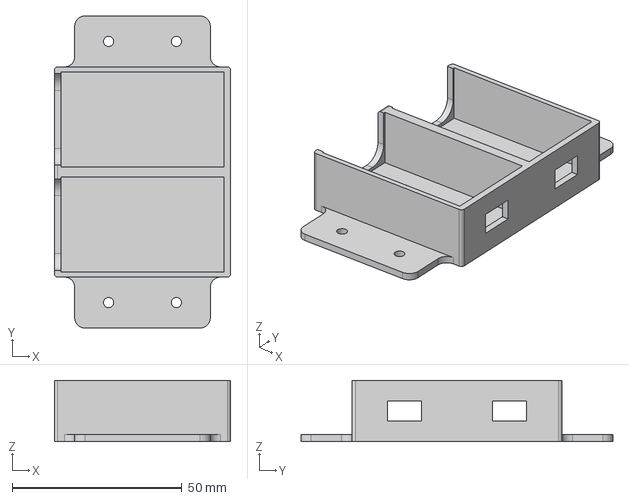
[picture p25: CAD file, 2026-04-10]
pid-obstacle-avoidance-robot/hardware/ARCHIVOS_CAD/Base_bateria.step
52.0 x 92.0 x 18.0 mm
