anghernandez/angie-projects/pid-obstacle-avoidance-robot/hardware/ARCHIVOS_CAD/Base_motor.step

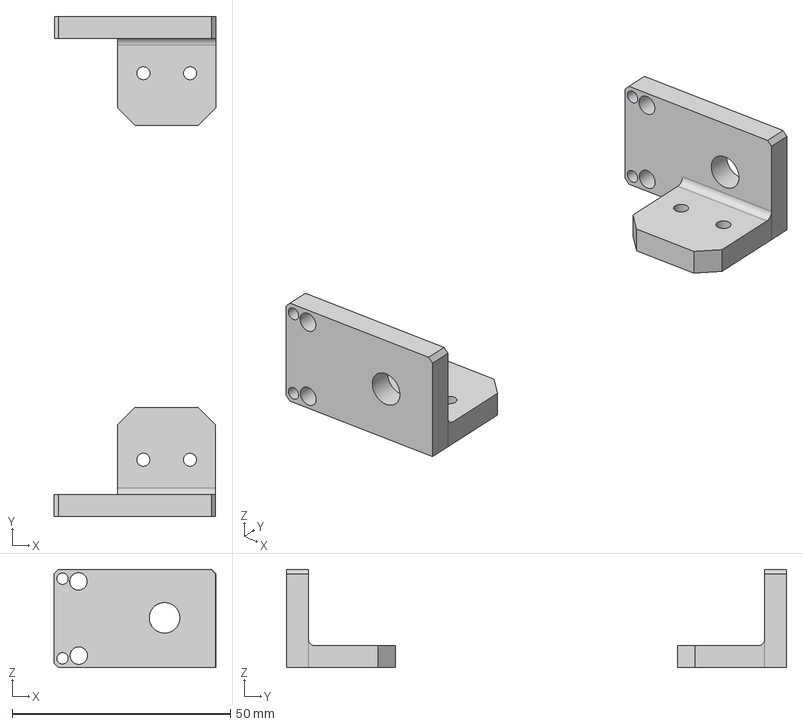
[picture p26: CAD file, 2026-04-10]
pid-obstacle-avoidance-robot/hardware/ARCHIVOS_CAD/Base_motor.step
37.0 x 114.5 x 22.5 mm
CSP-08
CSP-07
