anghernandez/angie-projects/pid-obstacle-avoidance-robot/hardware/PLANOS_CARRITO/Base Dibujo v1.pdf

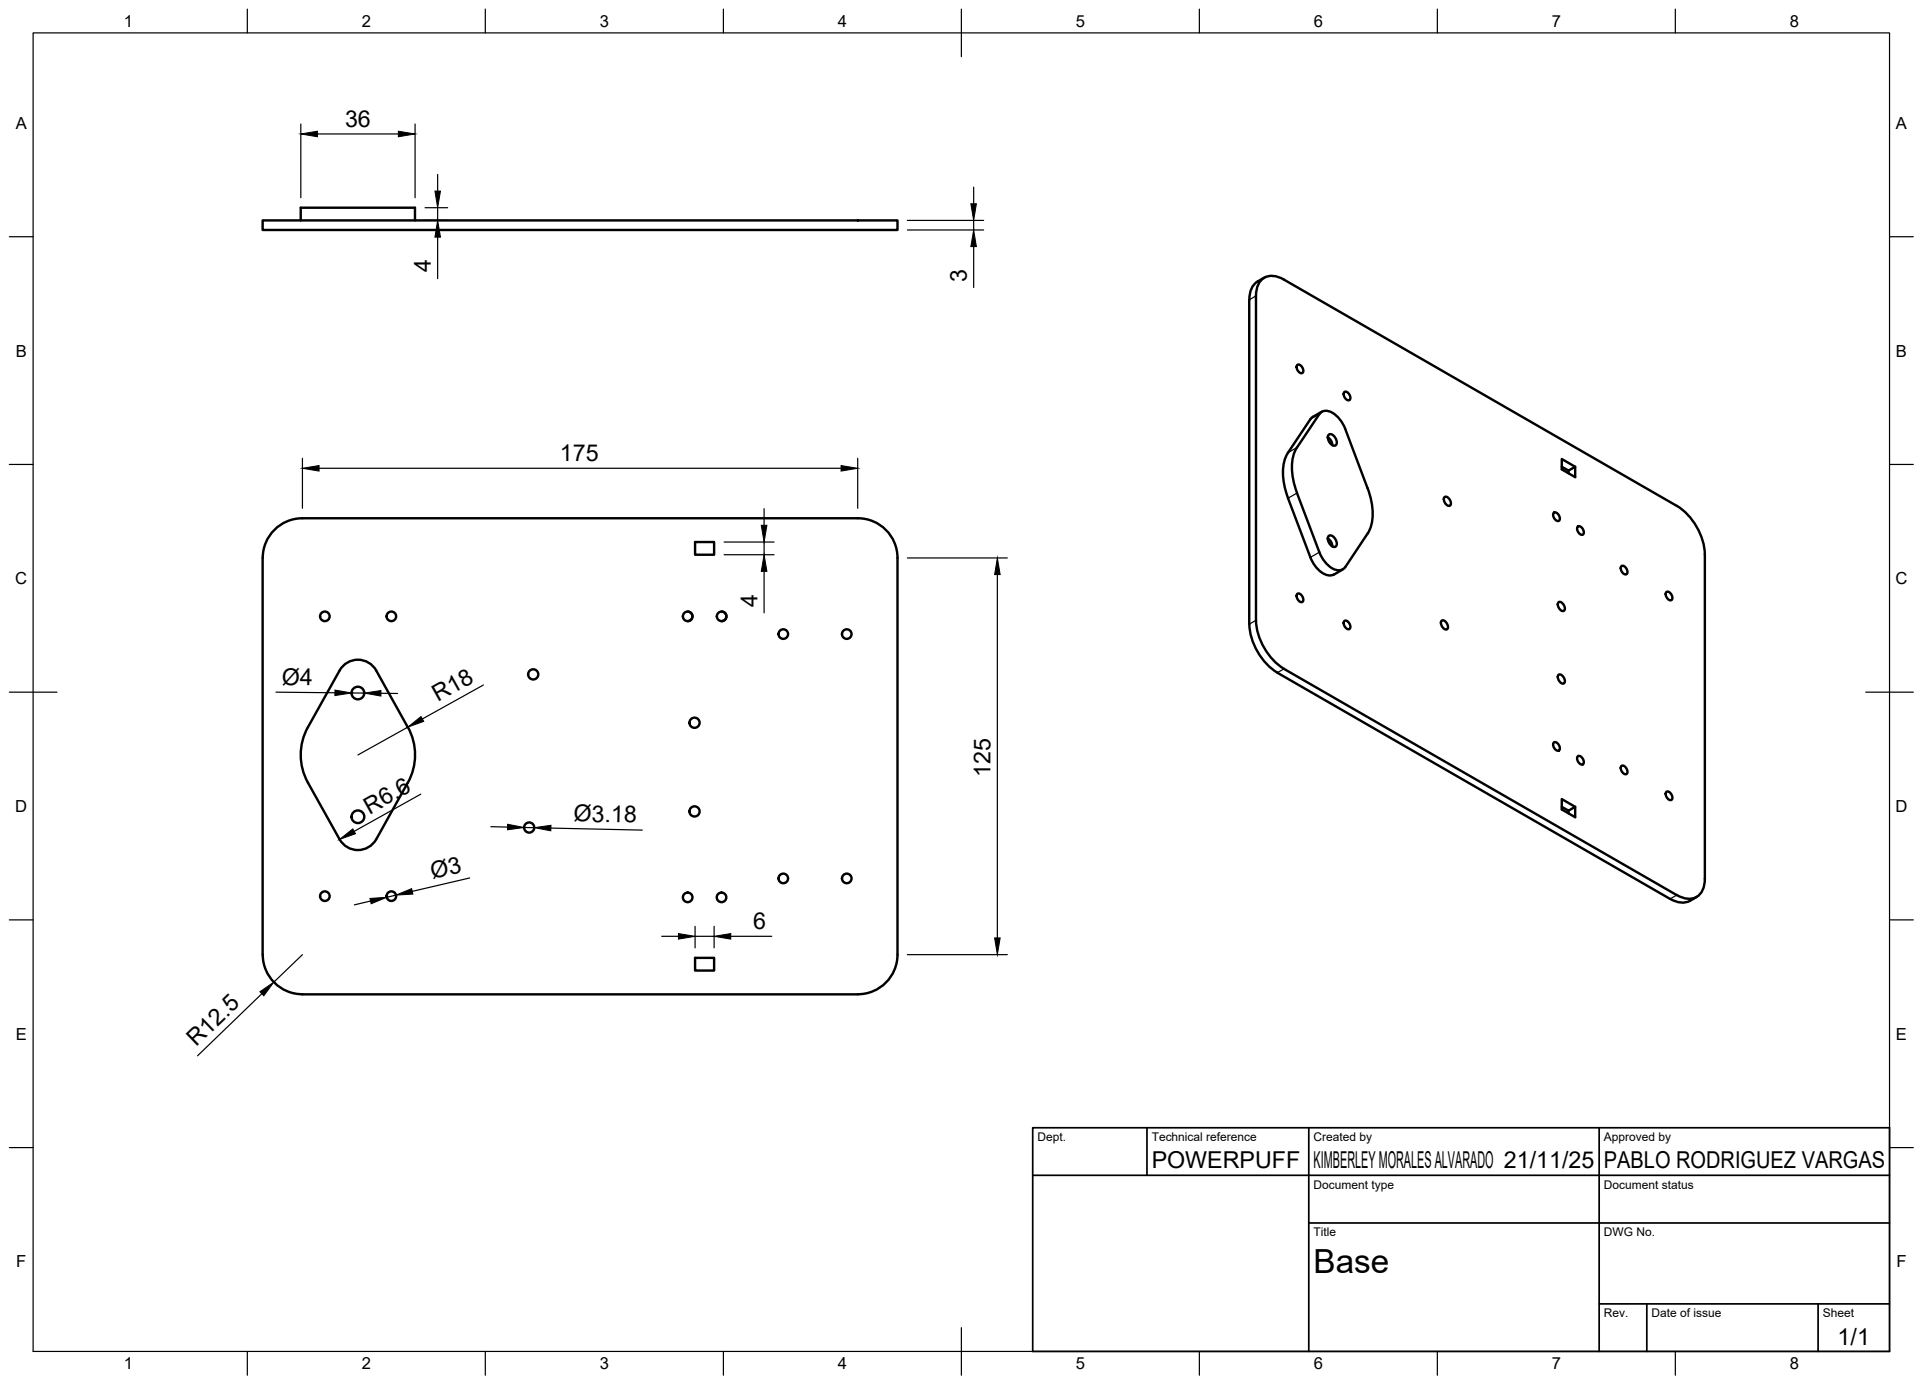
[picture p28: page 1]
Title; DWG No.; Rev.; Date of issue; Sheet

Dept. | Technical reference POWERPUFF | Created by KIMBERLEY MORALES ALVARADO 21/11/25 | Approved by PABLO RODRIGUEZ VARGAS

Document type | Document status
