anghernandez/angie-projects/pid-obstacle-avoidance-robot/hardware/PLANOS_CARRITO/base_driver v1.pdf

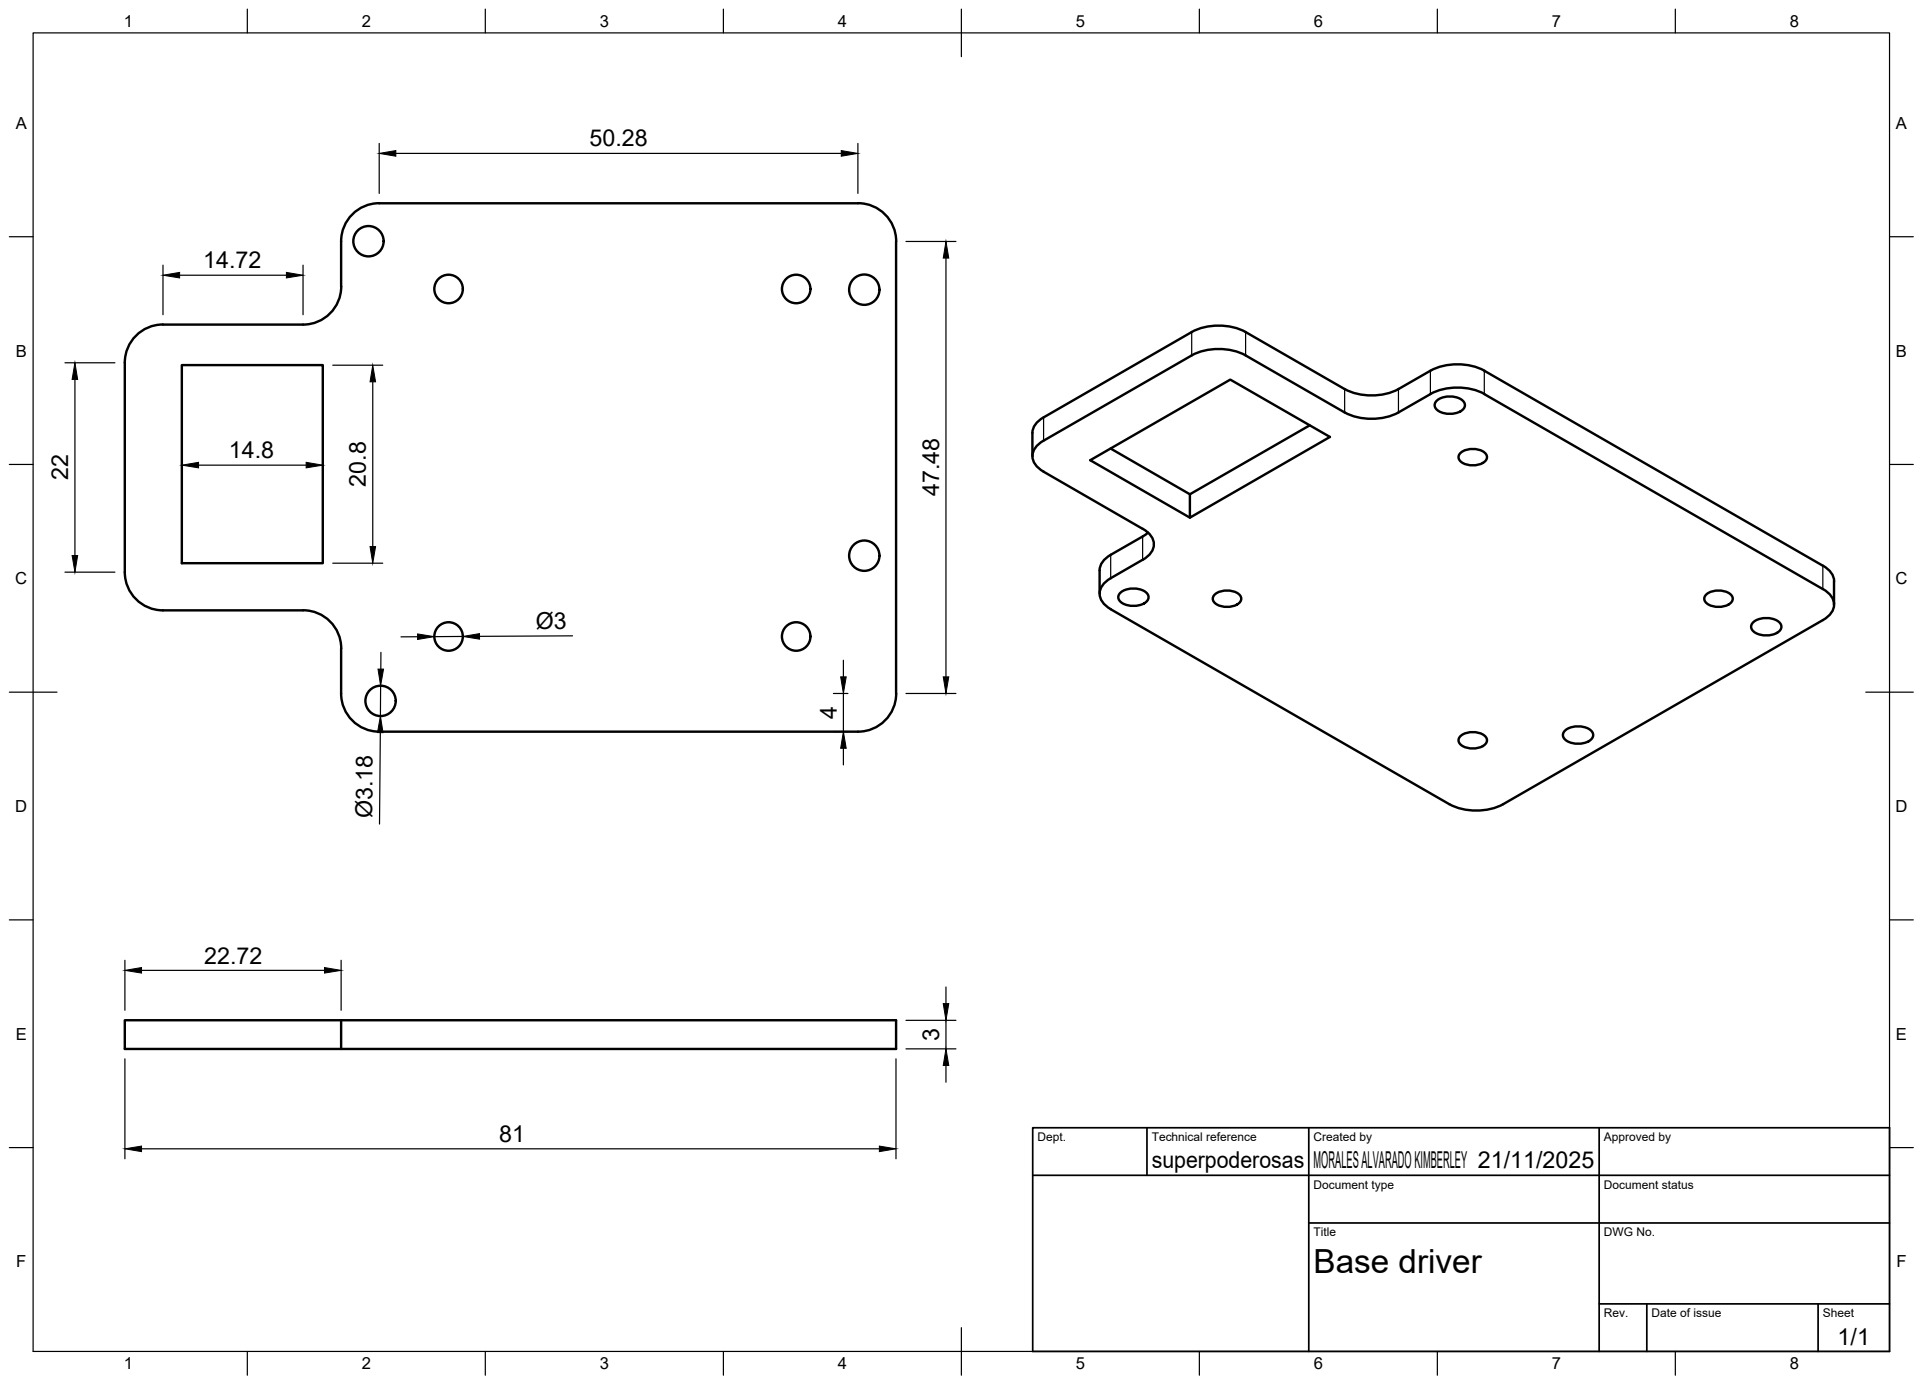
[picture p29: page 1]
Title; DWG No.; Rev.; Date of issue; Sheet; Base driver

Dept. | Technical reference superpoderosas | Created by MORALES ALVARADO KIMBERLEY 21/11/2025 | Approved by

Document type | Document status
