anghernandez/angie-projects/pid-obstacle-avoidance-robot/hardware/PLANOS_CARRITO/Ensamble v2.pdf

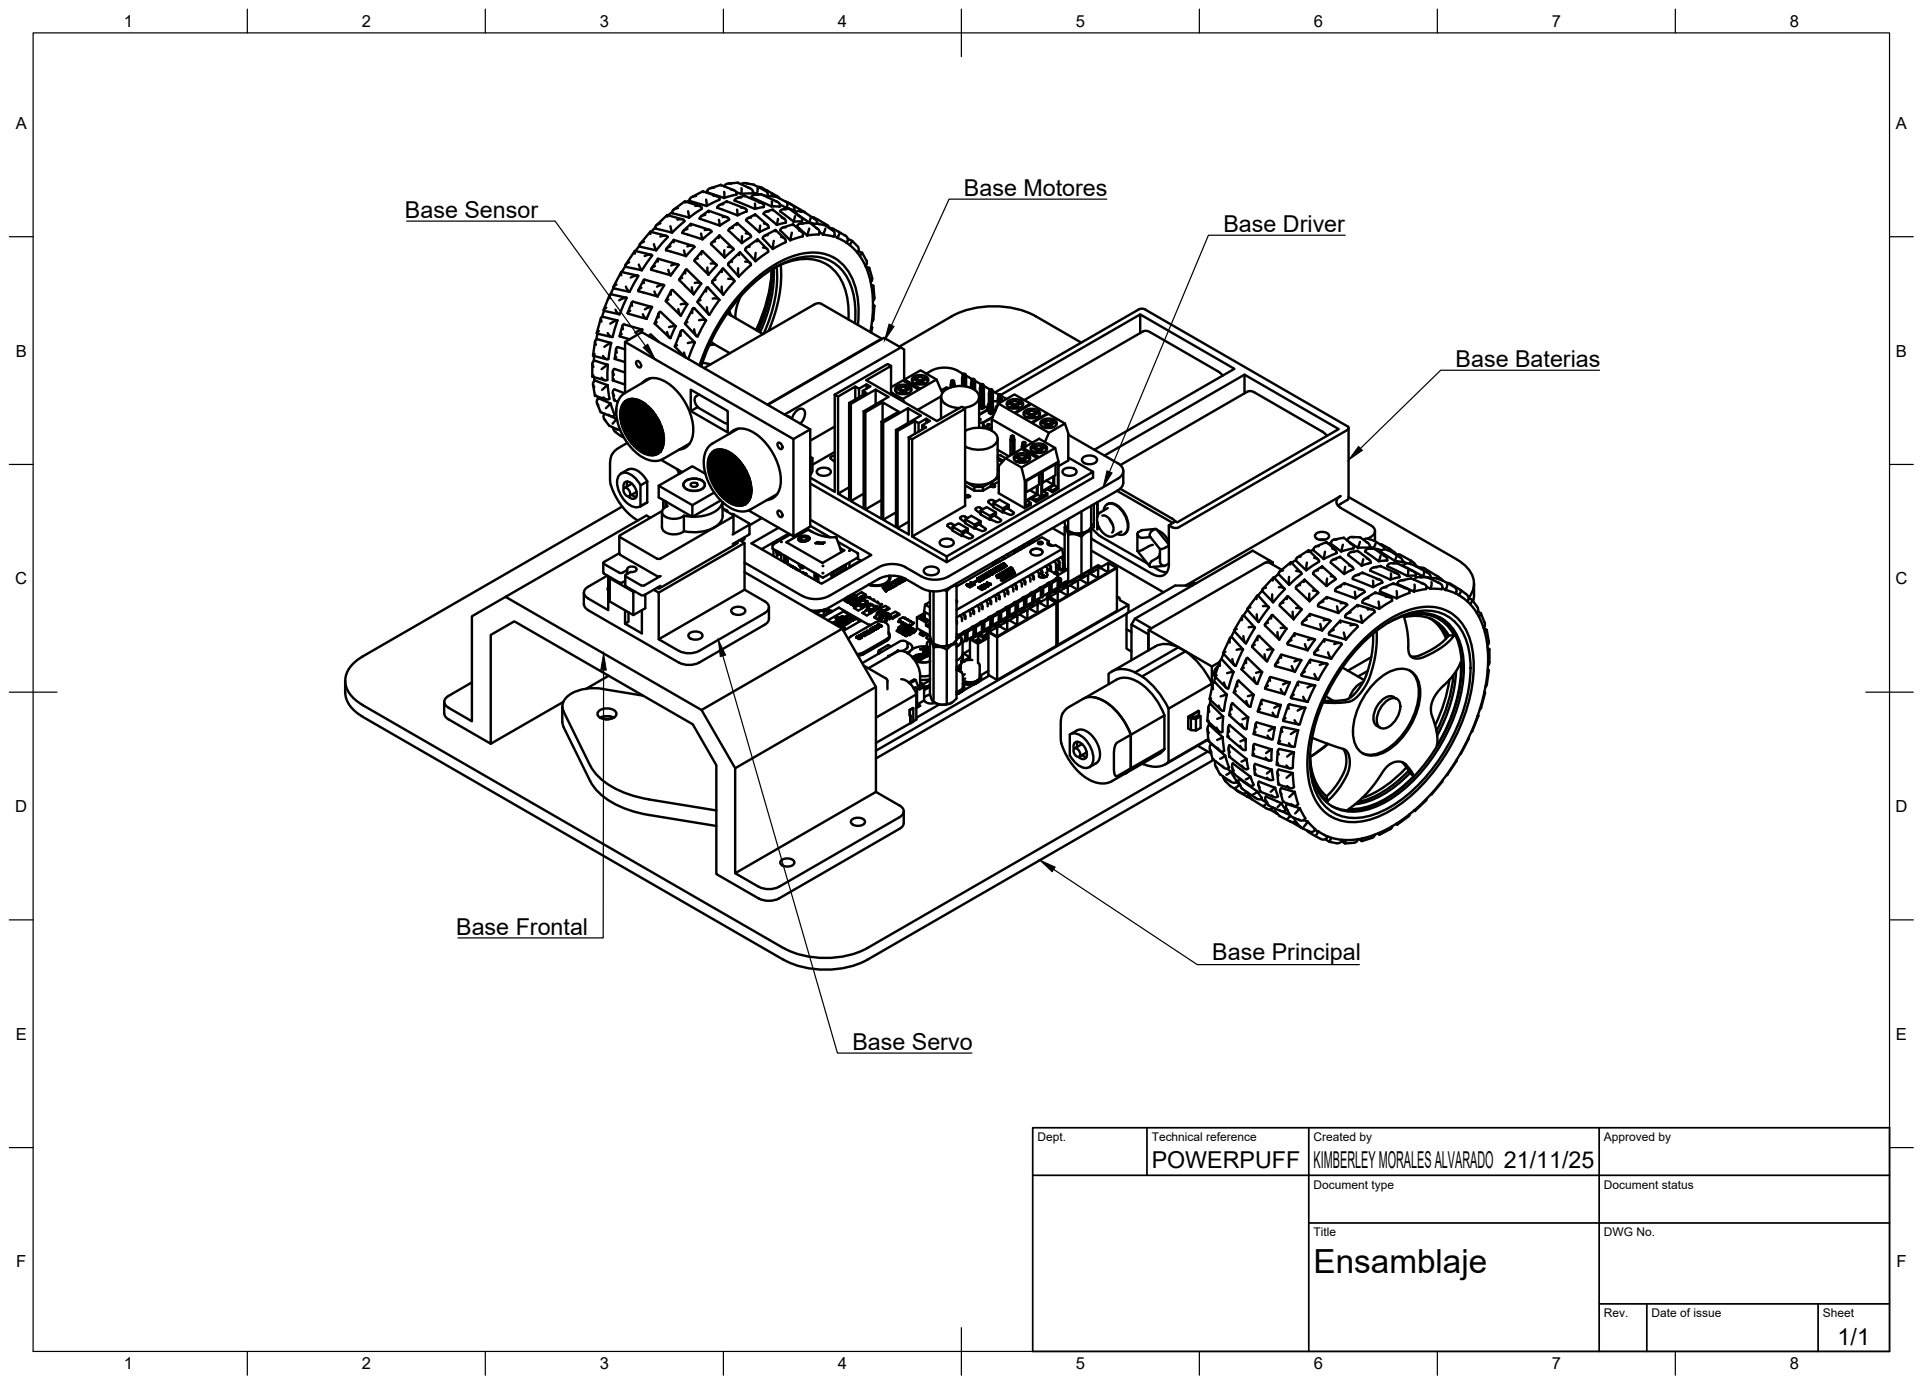
[picture p32: page 1]
Title; DWG No.; Rev.; Date of issue; Sheet; Base Principal; Base Frontal; Base Motores; Base Baterias; Base Driver; Base Servo; Base Sensor

Dept. | Technical reference POWERPUFF | Created by KIMBERLEY MORALES ALVARADO 21/11/25 | Approved by

Document type | Document status
