anghernandez/angie-projects/pid-obstacle-avoidance-robot/hardware/PLANOS_CARRITO/base_baterias v1.pdf

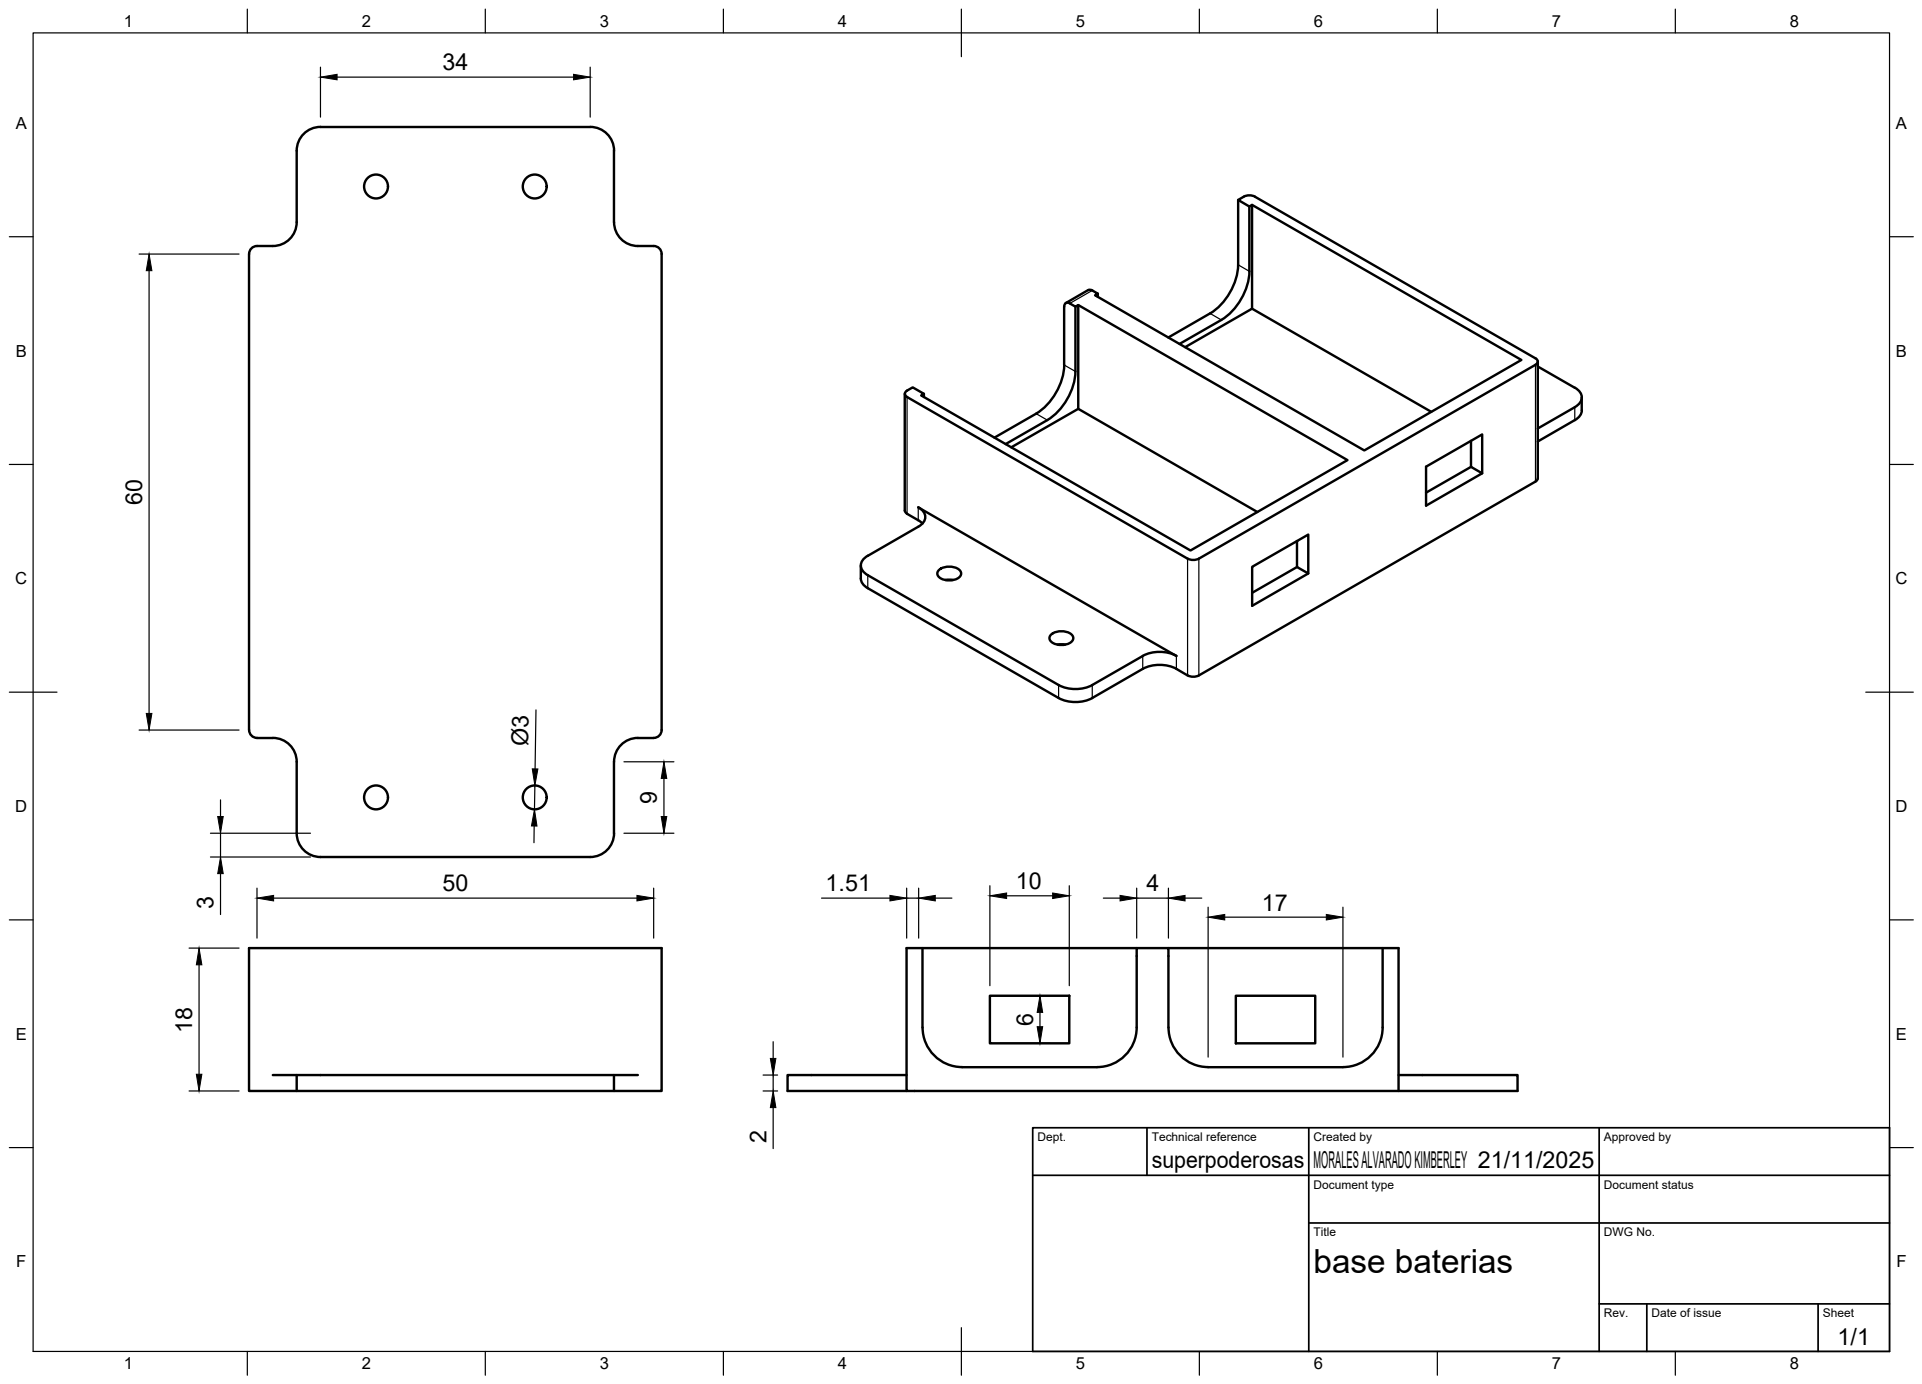
[picture p33: page 1]
Title; DWG No.; Rev.; Date of issue; Sheet; base baterias; superpoderosas; MORALES ALVARADO KIMBERLEY 60

Dept. | Technical reference | Created by 21/11/2025 | Approved by

Document type | Document status
