anghernandez/angie-projects/pid-obstacle-avoidance-robot/hardware/PLANOS_CARRITO/base_sensor v1.pdf

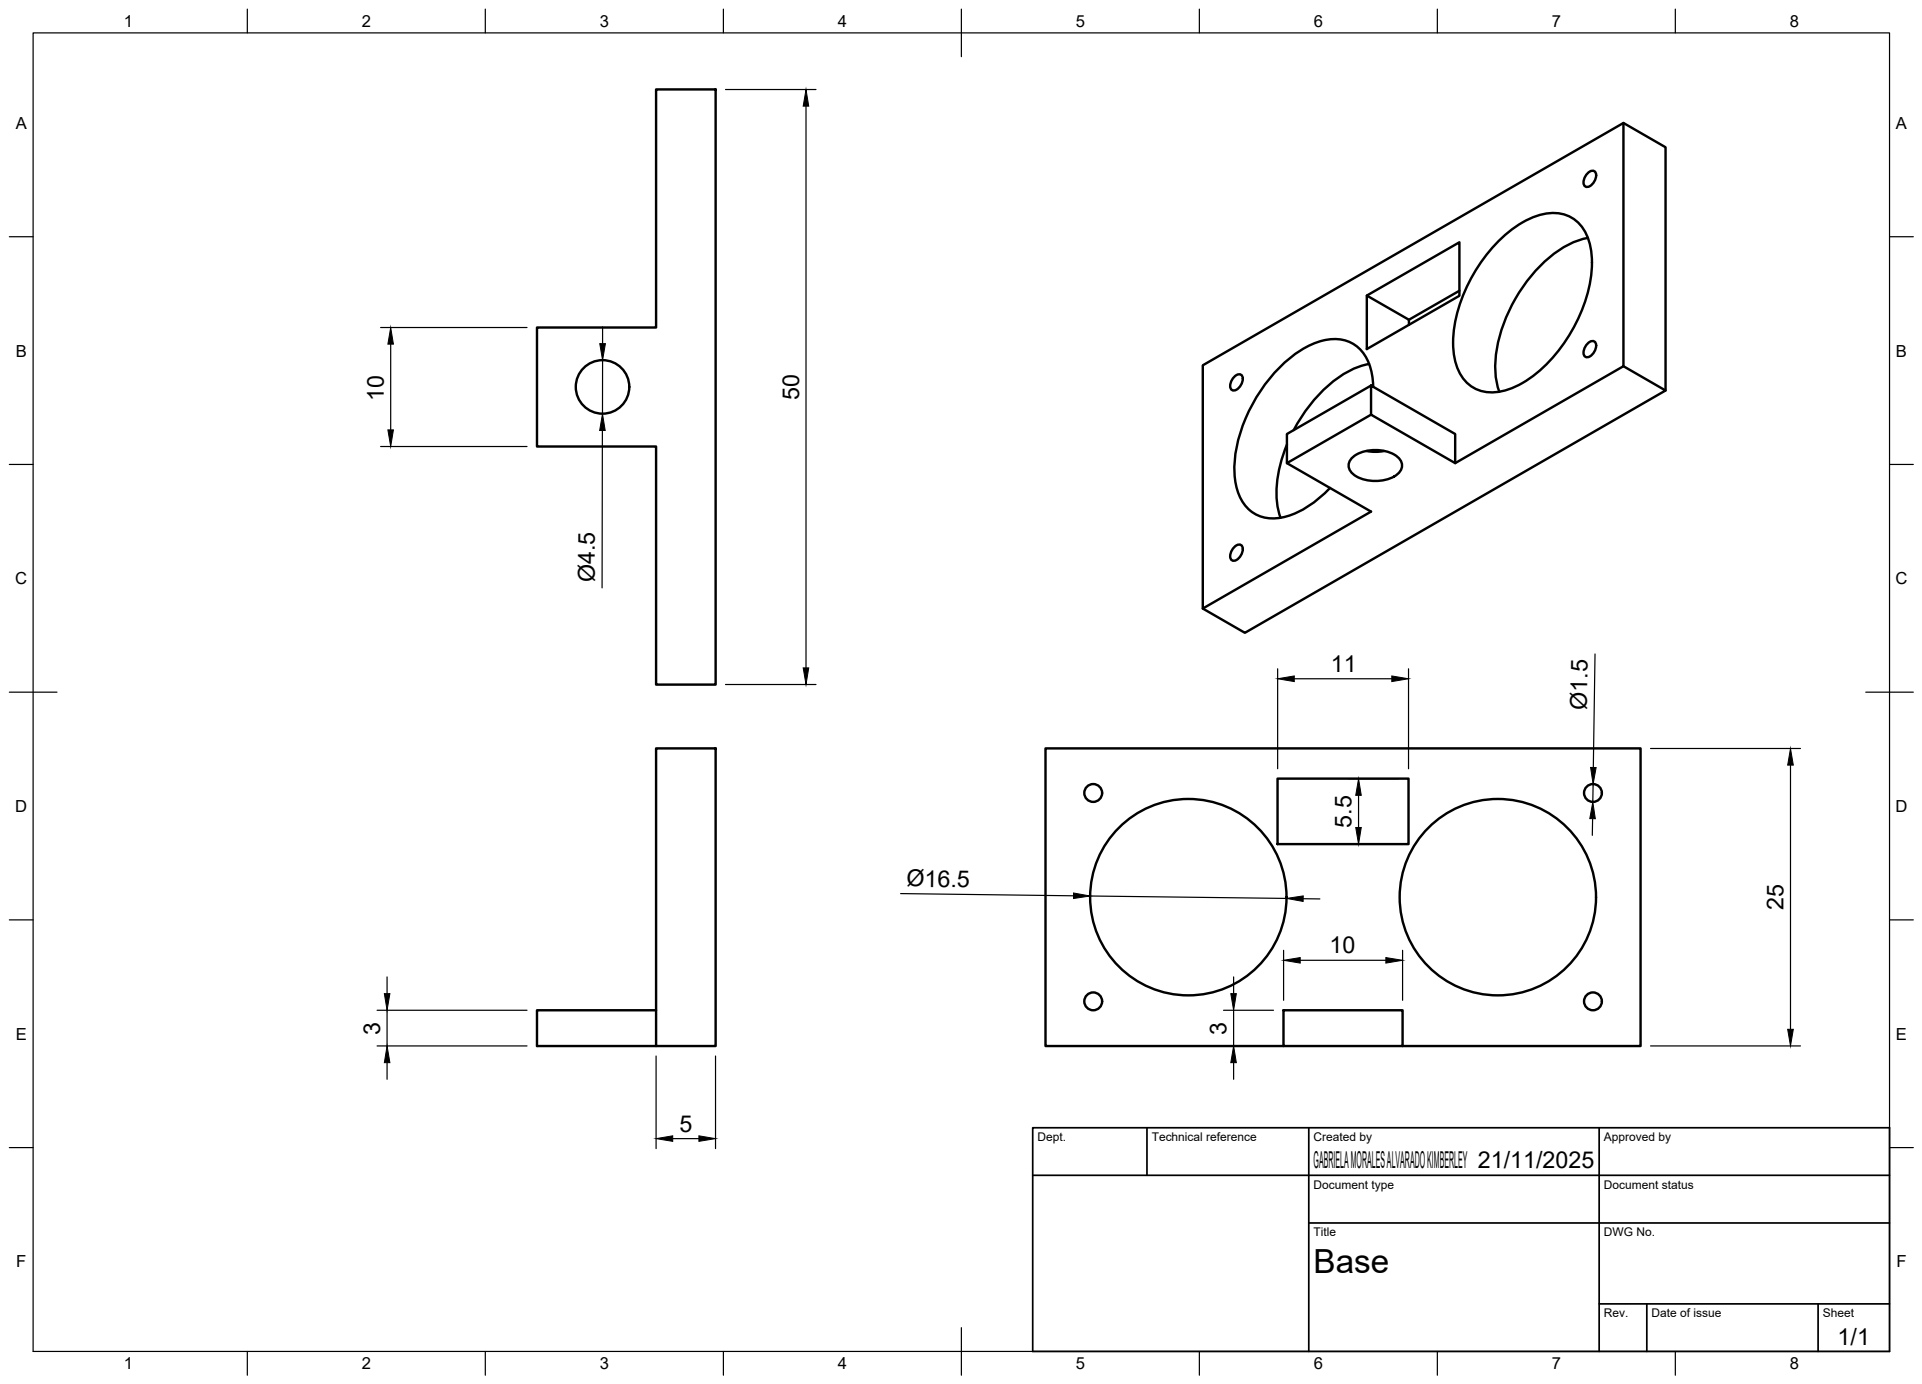
[picture p34: page 1]
Title; DWG No.; Rev.; Date of issue; Sheet; GABRIELA MORALES ALVARADO KIMBERLEY 10

Dept. | Technical reference | Created by 21/11/2025 | Approved by

Document type | Document status
