anghernandez/angie-projects/(commit log)

2026-04-10 Add PID obstacle avoidance robot project with code, docs and hardware files
    [Arco.step, Base.step, Base_bateria.step, Base_driver.step, Base_motor.step, Base_sensor.step, Base_servo.step]
2026-04-10 Add README for PID Obstacle Avoidance Robot project
    This README provides an overview of the PID obstacle avoidance robot project, detailing its objectives, system architecture, control strategy, repository structure, and getting started instructions.
